EA5IOT/Medidor-de-ruido-solar/README.md

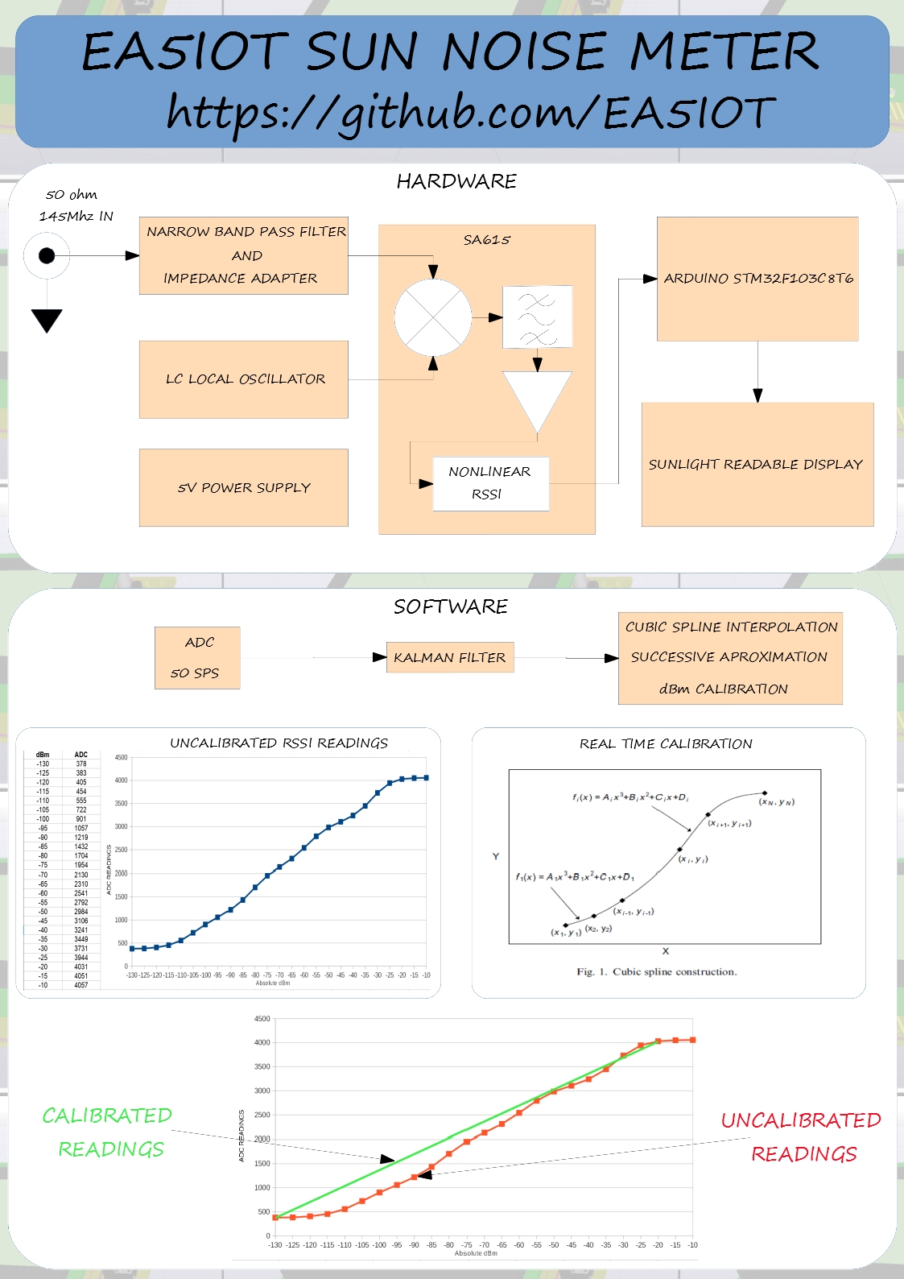
[picture p1: assets/import.png]
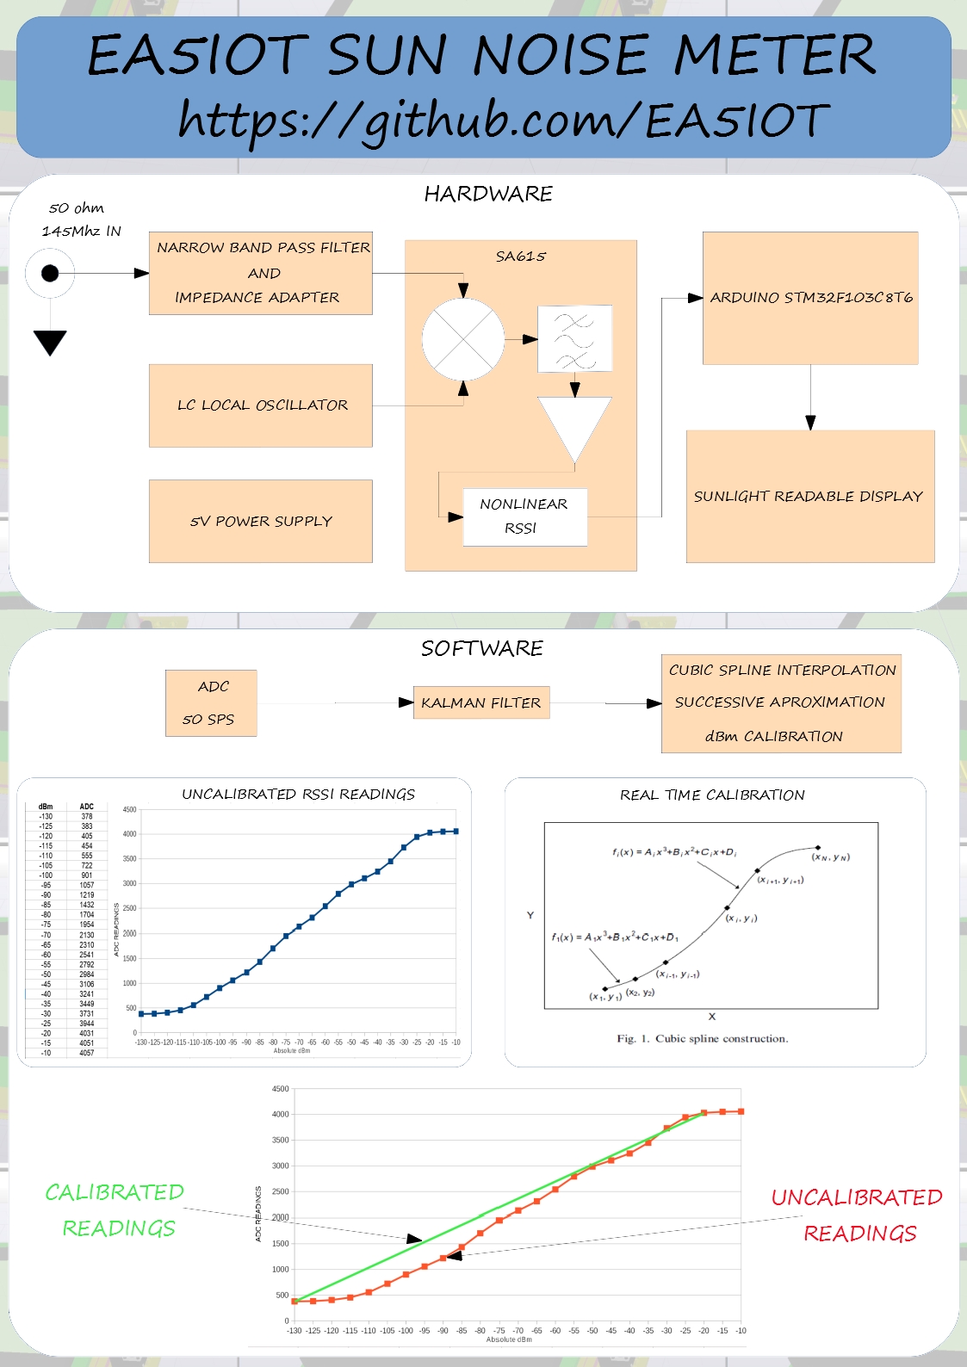
[picture p2: assets/Presentacion1.jpg]
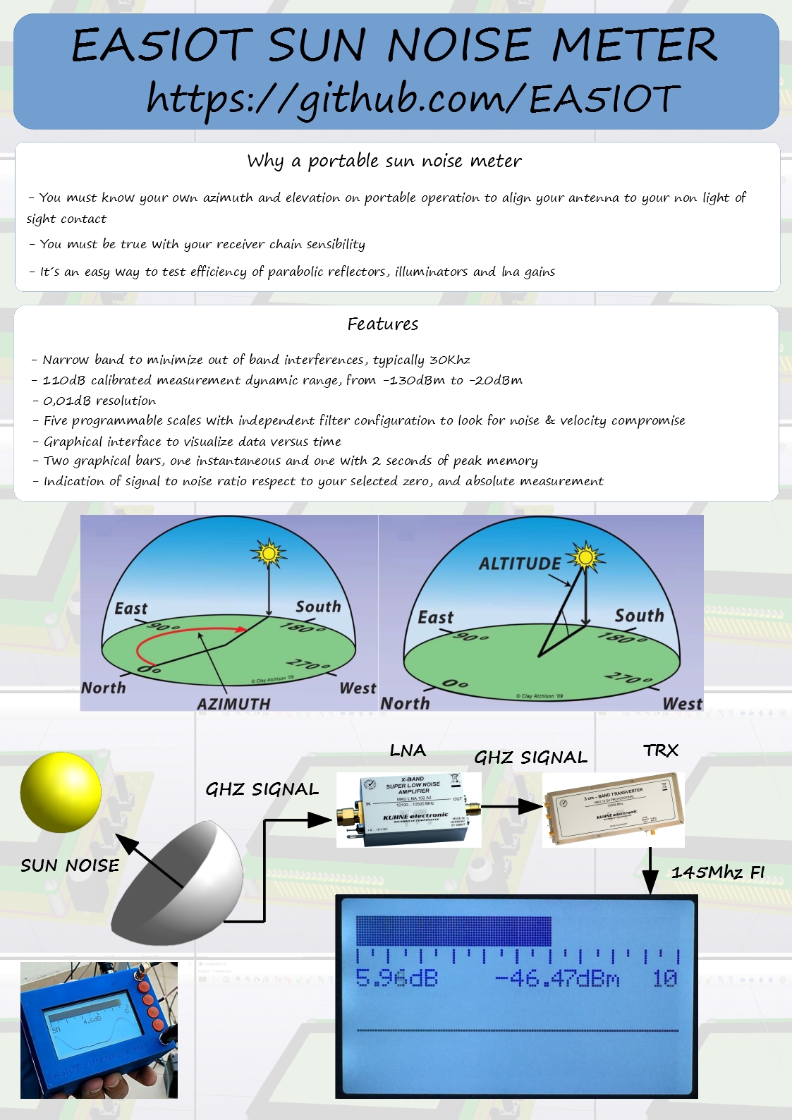
[picture p3: assets/Presentacion2.jpg]
