EA5IOT/Medidor-de-ruido-solar/Medidor_ruido_solar/Presentacion/EATIOT SUN NOISE METER.pdf

## HARDWARE

# EA5IOT SUN NOISE METER

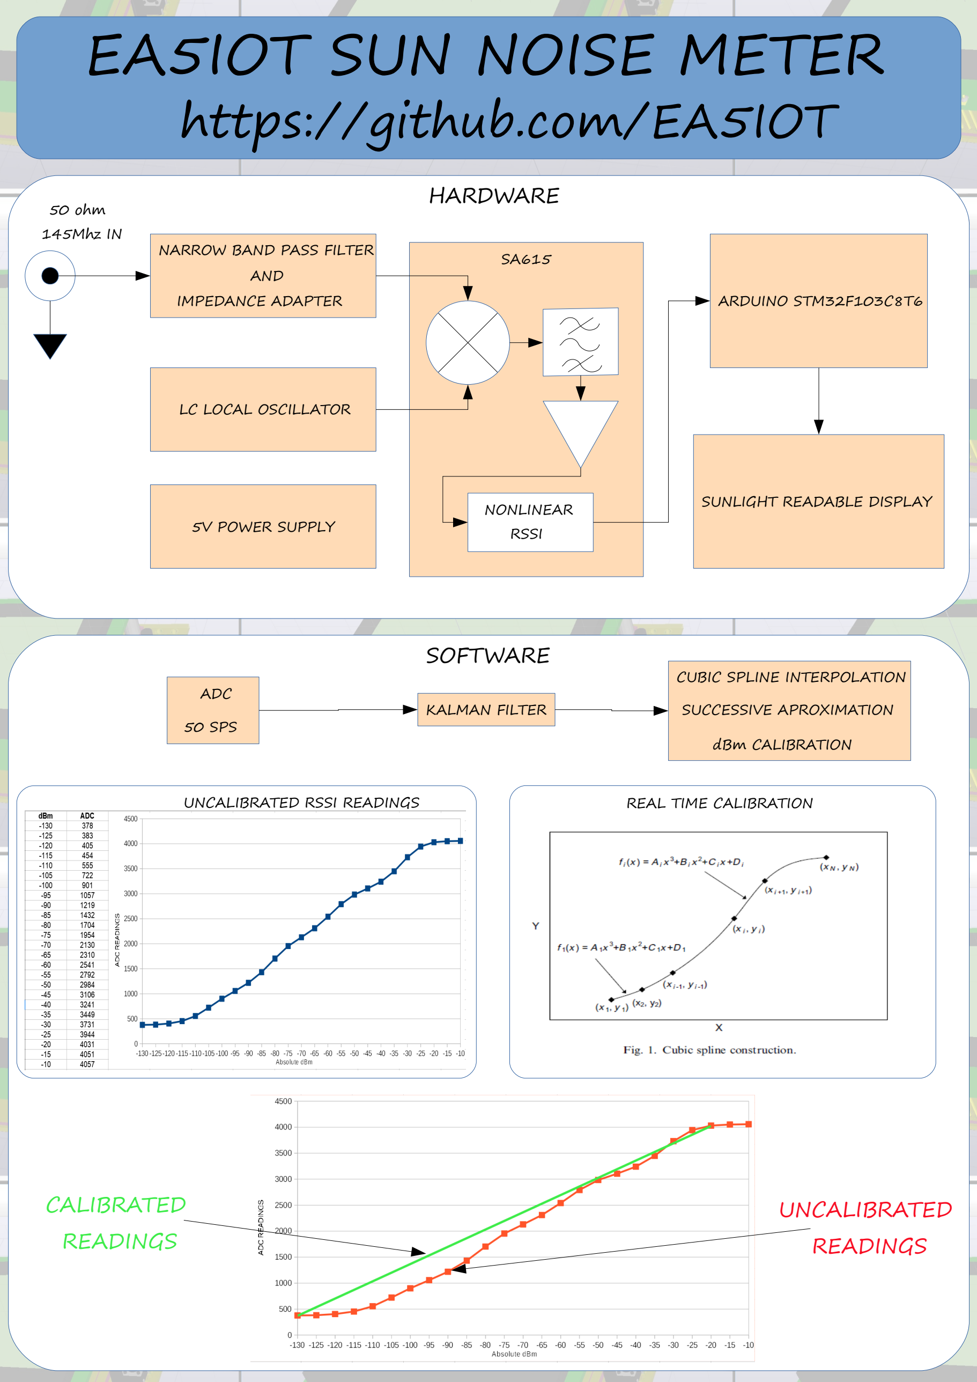
[picture p4: page 1]

NARROW BAND PASS FILTER
AND
IMPEDANCE ADAPTER

5V POWER SUPPLY

SA615

LC LOCAL OSCILLATOR

RSSI

ARDUINO STM32F103C8T6

SUNLIGHT READABLE DISPLAY

## SOFTWARE

ADC
50 SPS

KALMAN FILTER

CUBIC SPLINE INTERPOLATION SUCCESSIVE APROXIMATION

50 ohm
145Mhz IN

dBm CALIBRATION

NONLINEAR

UNCALIBRATED RSSI READINGS | REAL TIME CALIBRATION

## UNCALIBRATED READINGS

## CALIBRATED READINGS

# https://github.com/EA5IOT

# EA5IOT SUN NOISE METER

# https://github.com/EA5IOT

## Why a portable sun noise meter

- You must know your own azimuth and elevation on portable operation to align your antenna to your non light of sight contact
- You must be true with your receiver chain sensibility
- It´s an easy way to test efficiency of parabolic reflectors, illuminators and lna gains

## Features

- Narrow band to minimize out of band interferences, typically 30Khz
- 110dB calibrated measurement dynamic range, from -130dBm to -20dBm
- 0,01dB resolution
- Five programmable scales with independent filter configuration to look for noise & velocity compromise
- Graphical interface to visualize data versus time
- Two graphical bars, one instantaneous and one with 2 seconds of peak memory
- Indication of signal to noise ratio respect to your selected zero, and absolute measurement

## SUN NOISE

## GHZ SIGNAL

GHZ SIGNAL LNA | TRX

## 145Mhz FI
