EA5IOT/Medidor-de-ruido-solar/Medidor_ruido_solar/Fotos/428928830_282178.jpg

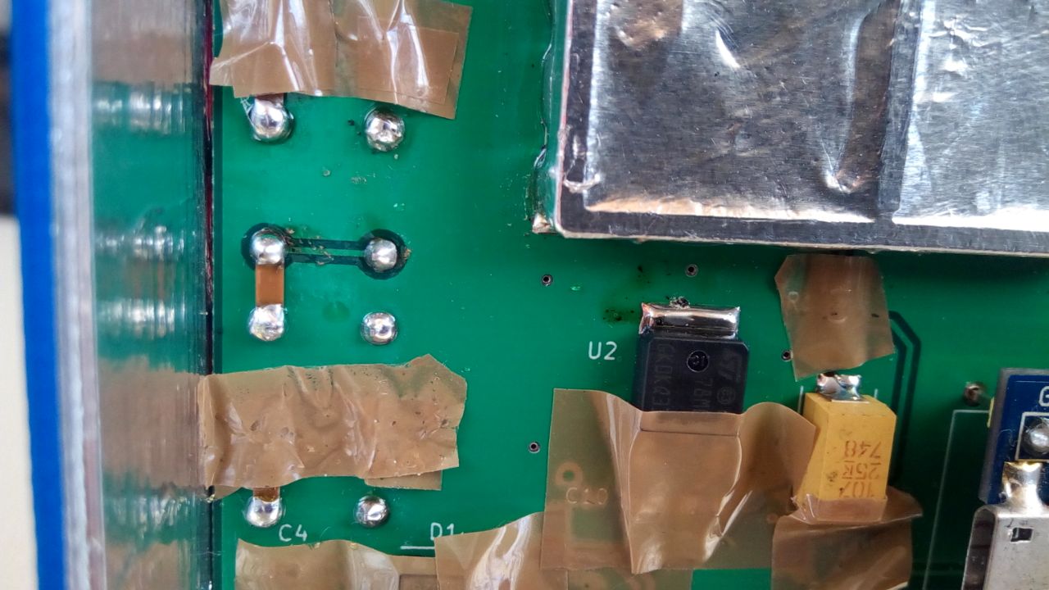
Medidor_ruido_solar/Fotos/428928830_282178.jpg
