EA5IOT/Medidor-de-ruido-solar/Medidor_ruido_solar/Fotos/428933439_148707.jpg

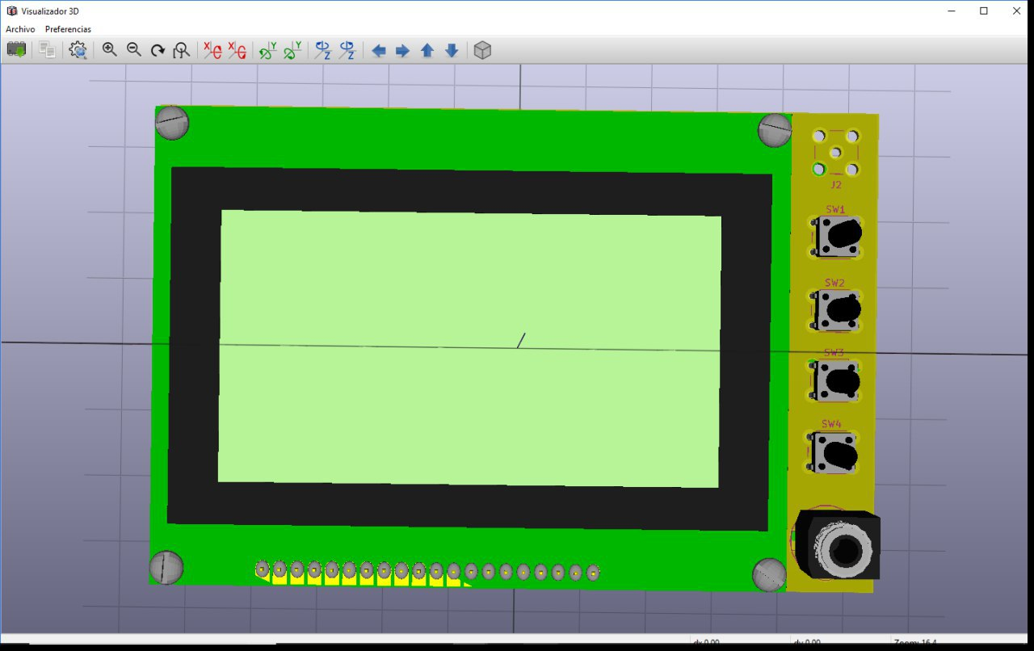
Medidor_ruido_solar/Fotos/428933439_148707.jpg
