EA5IOT/Medidor-de-ruido-solar/Medidor_ruido_solar/Fotos/428935115_189661.jpg

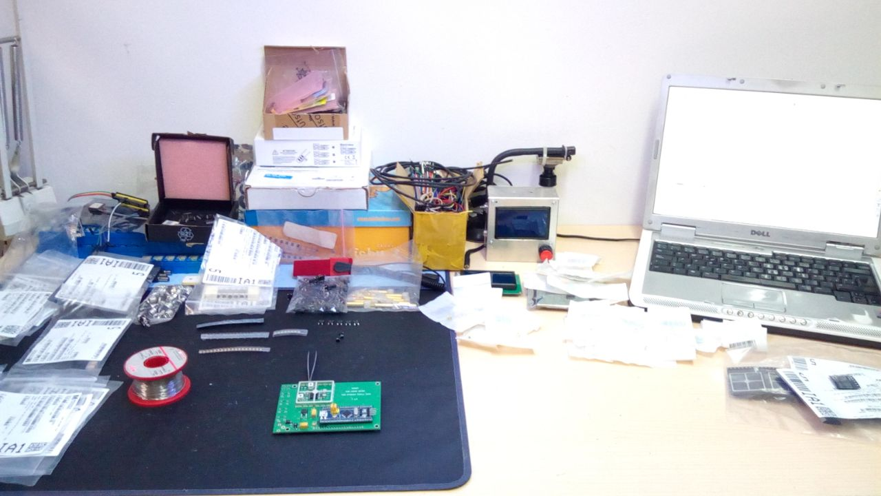
Medidor_ruido_solar/Fotos/428935115_189661.jpg
