EA5IOT/Medidor-de-ruido-solar/Medidor_ruido_solar/Fotos/428937697_245249.jpg

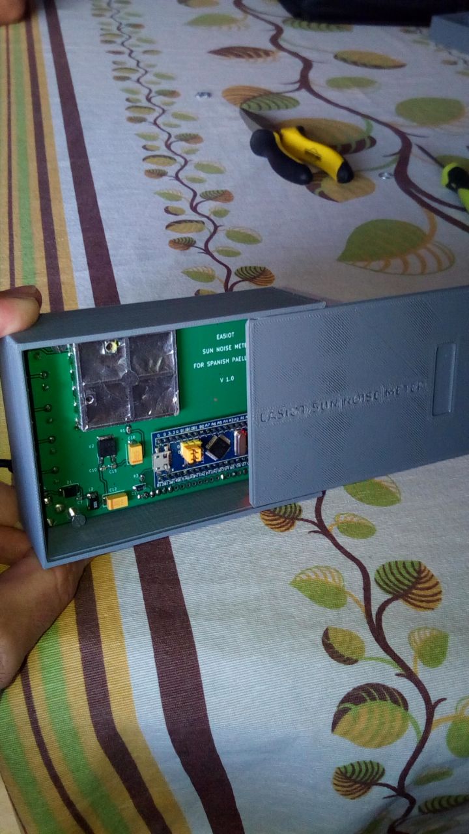
Medidor_ruido_solar/Fotos/428937697_245249.jpg
