EA5IOT/Medidor-de-ruido-solar/Medidor_ruido_solar/Fotos/435502254_330888.jpg

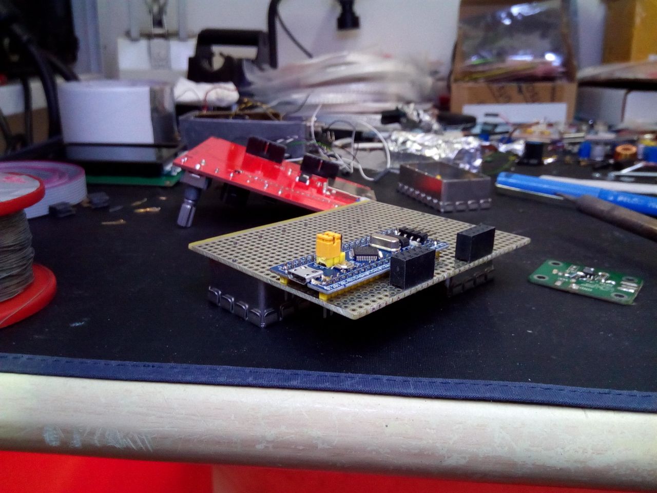
Medidor_ruido_solar/Fotos/435502254_330888.jpg
