EA5IOT/Medidor-de-ruido-solar/Medidor_ruido_solar/Fotos/435504594_331603.jpg

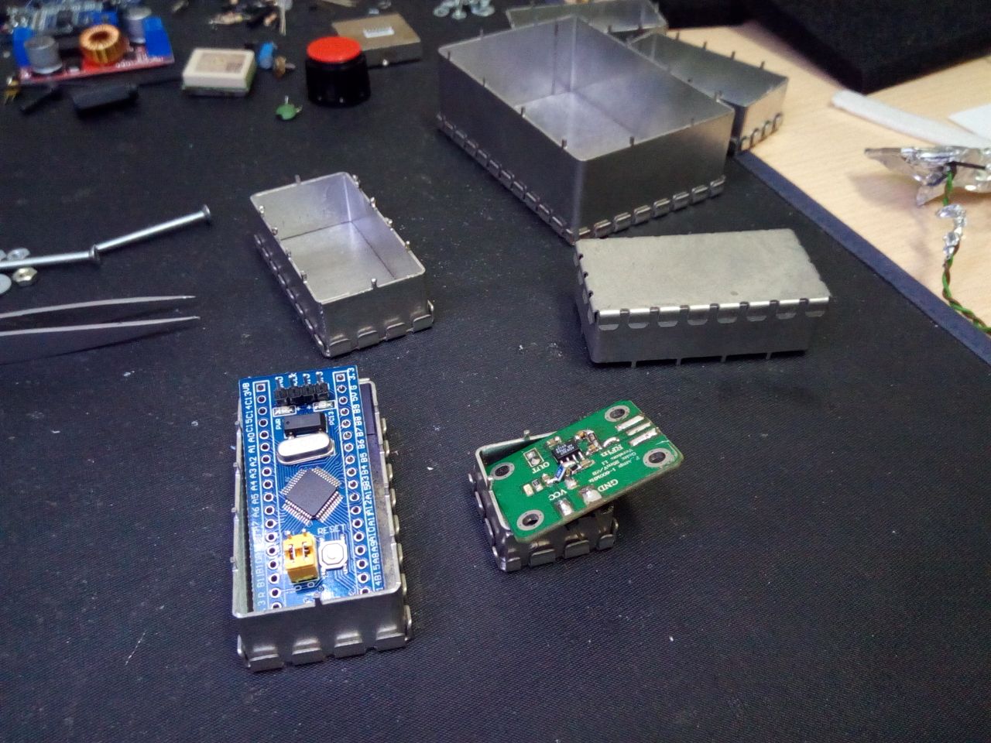
Medidor_ruido_solar/Fotos/435504594_331603.jpg
