EA5IOT/Medidor-de-ruido-solar/Medidor_ruido_solar/Fotos/438711929_137093.jpg

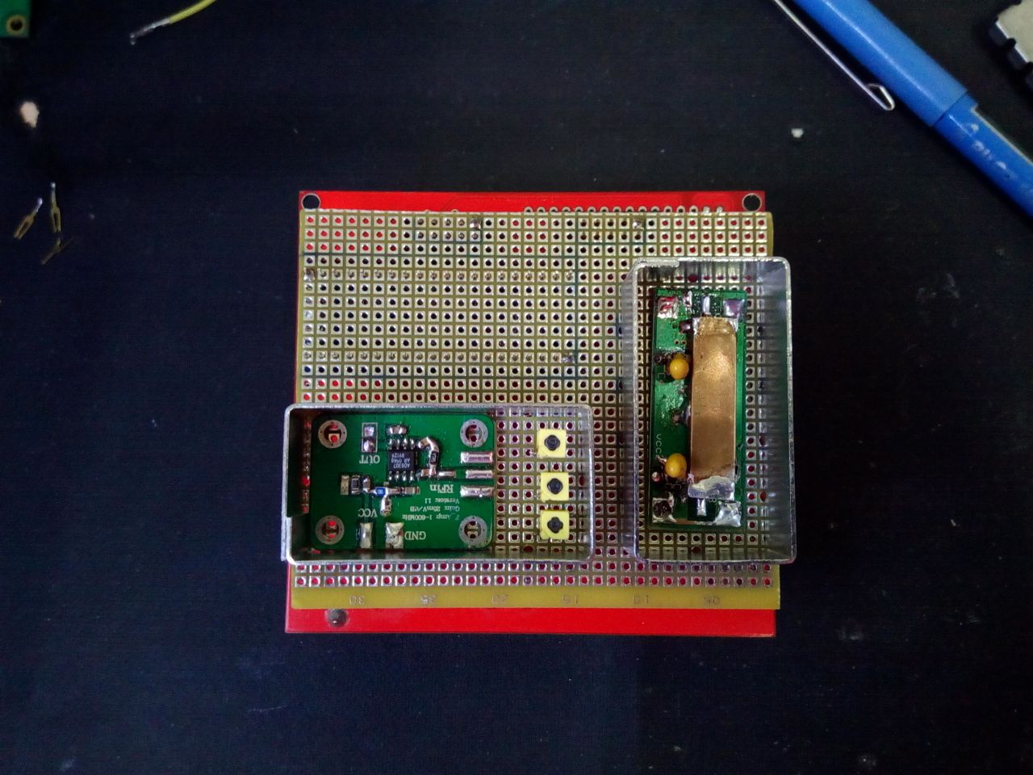
Medidor_ruido_solar/Fotos/438711929_137093.jpg
