EA5IOT/Medidor-de-ruido-solar/Medidor_ruido_solar/Fotos/438714214_136018.jpg

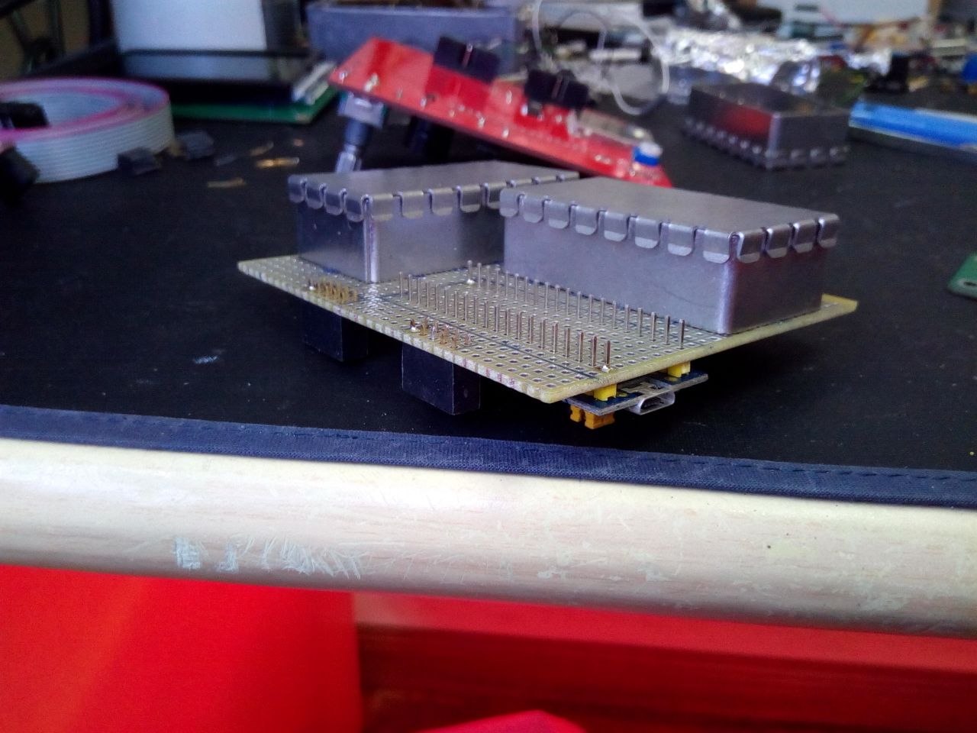
Medidor_ruido_solar/Fotos/438714214_136018.jpg
