EA5IOT/Medidor-de-ruido-solar/Medidor_ruido_solar/Fotos/438714601_136113.jpg

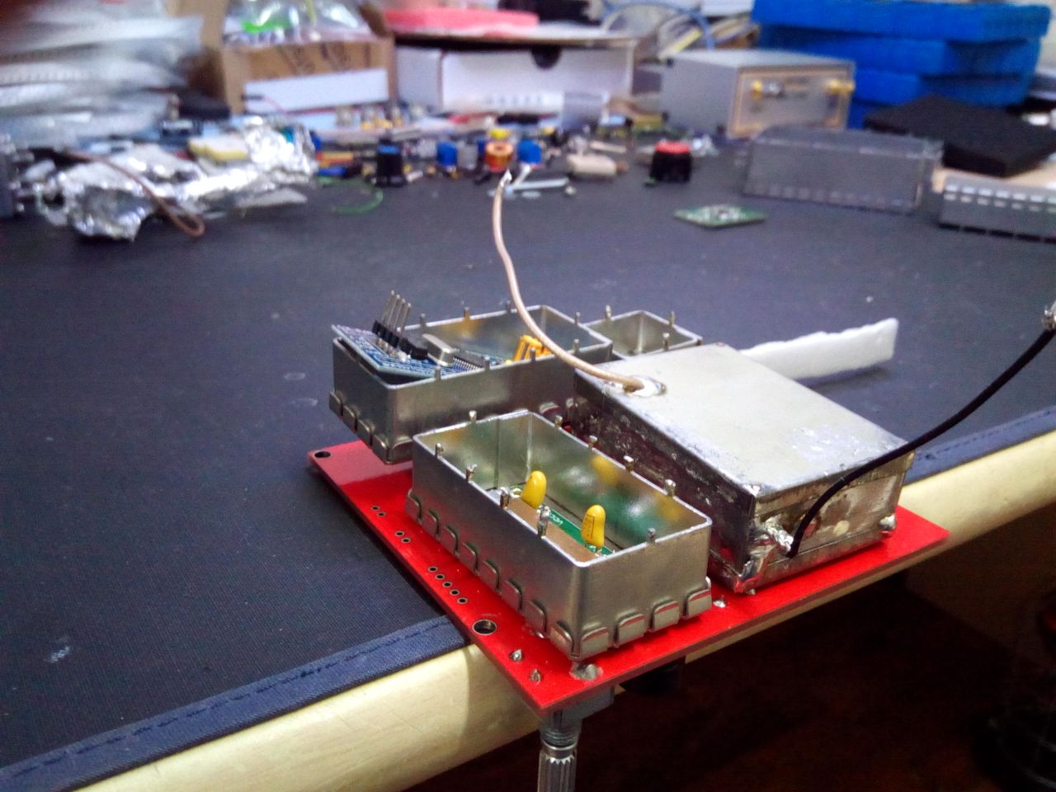
Medidor_ruido_solar/Fotos/438714601_136113.jpg
