EA5IOT/Medidor-de-ruido-solar/Medidor_ruido_solar/Fotos/438718184_130150.jpg

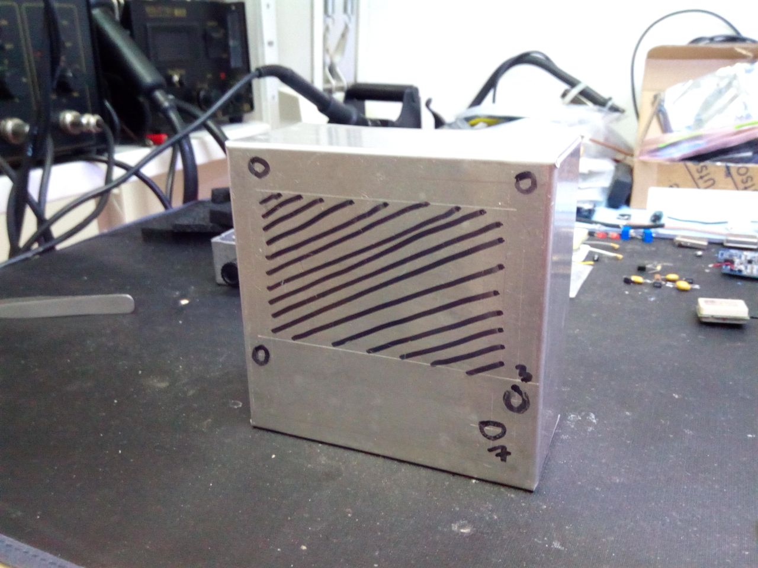
Medidor_ruido_solar/Fotos/438718184_130150.jpg
