EA5IOT/Medidor-de-ruido-solar/Medidor_ruido_solar/Fotos/439017442_168627.jpg

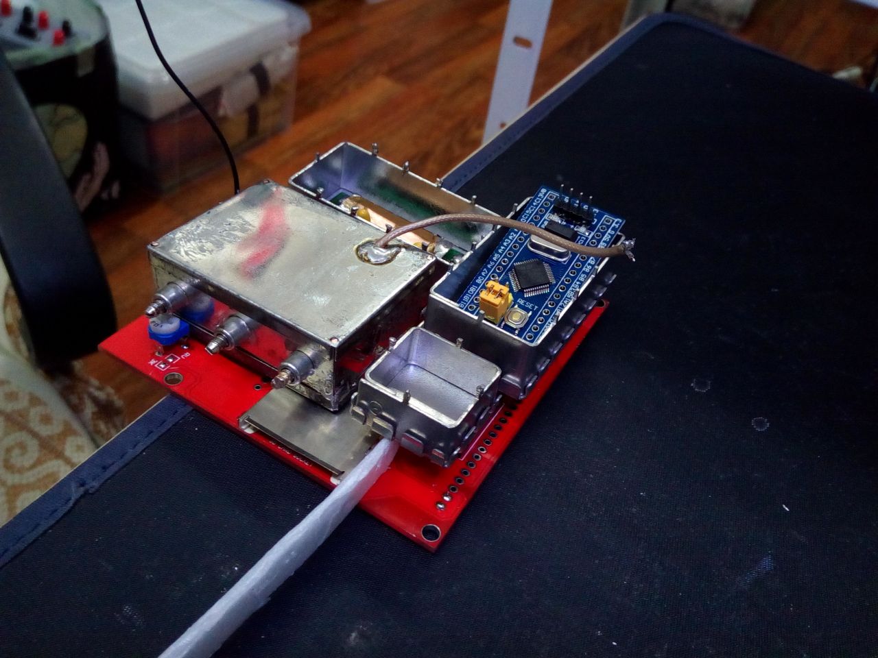
Medidor_ruido_solar/Fotos/439017442_168627.jpg
