EA5IOT/Medidor-de-ruido-solar/Medidor_ruido_solar/Fotos/439632301_316374.jpg

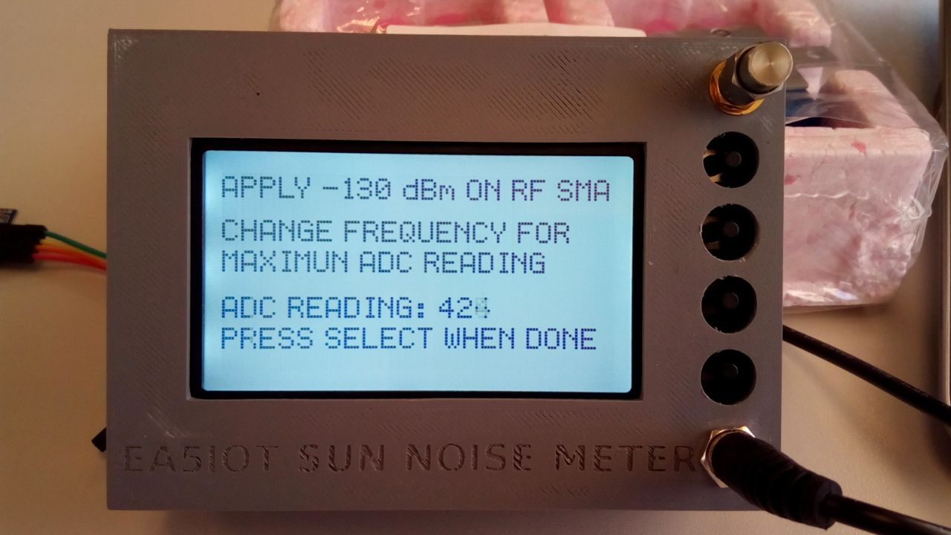
Medidor_ruido_solar/Fotos/439632301_316374.jpg
