EA5IOT/Medidor-de-ruido-solar/Medidor_ruido_solar/Fotos/439636108_252539.jpg

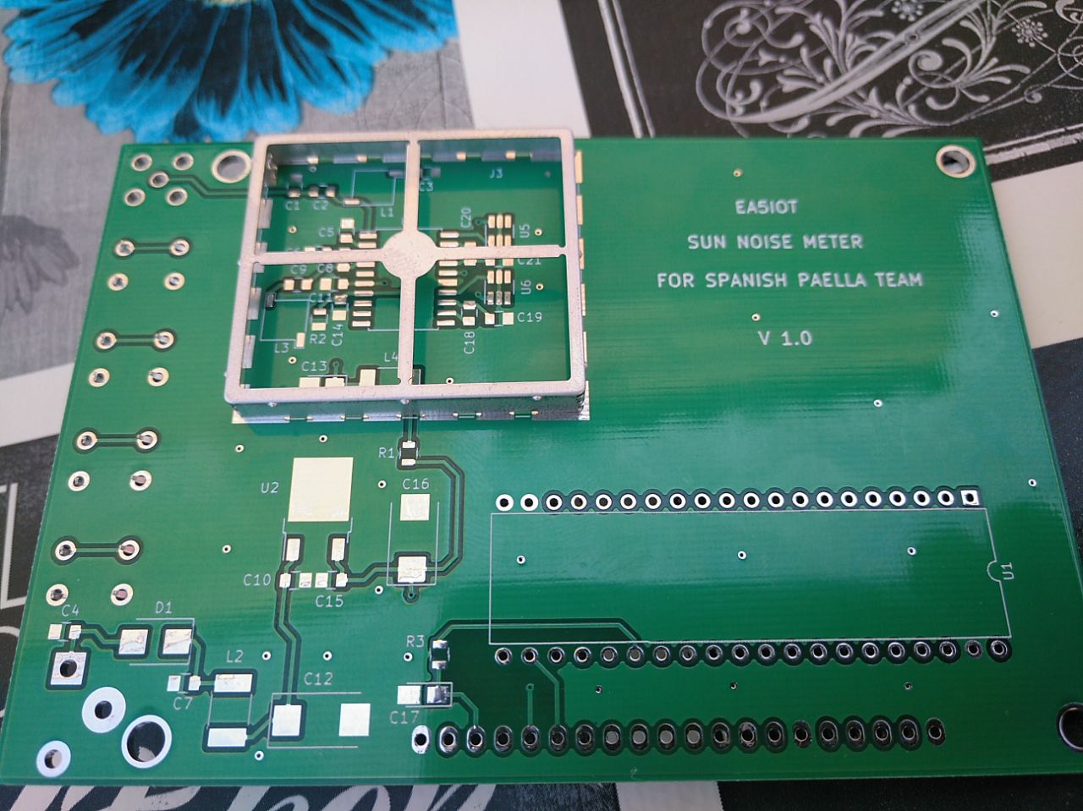
Medidor_ruido_solar/Fotos/439636108_252539.jpg
