EA5IOT/Medidor-de-ruido-solar/Medidor_ruido_solar/Fotos/439636724_227444.jpg

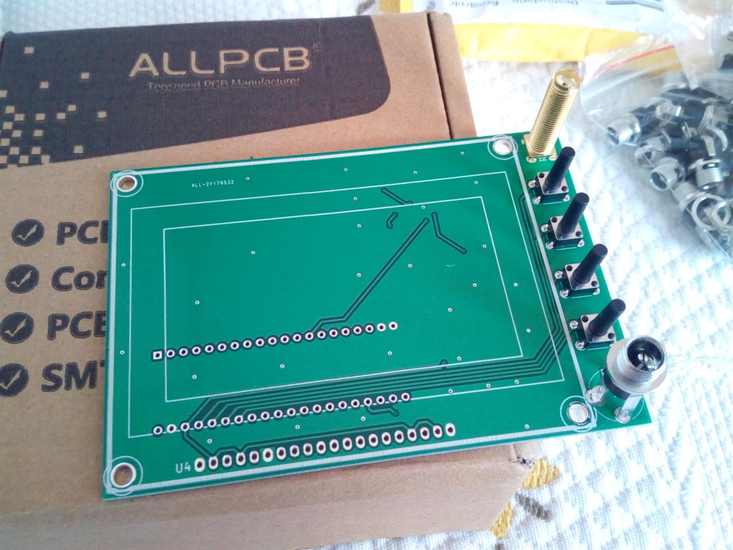
Medidor_ruido_solar/Fotos/439636724_227444.jpg
