EA5IOT/Medidor-de-ruido-solar/Medidor_ruido_solar/Fotos/439639487_311773.jpg

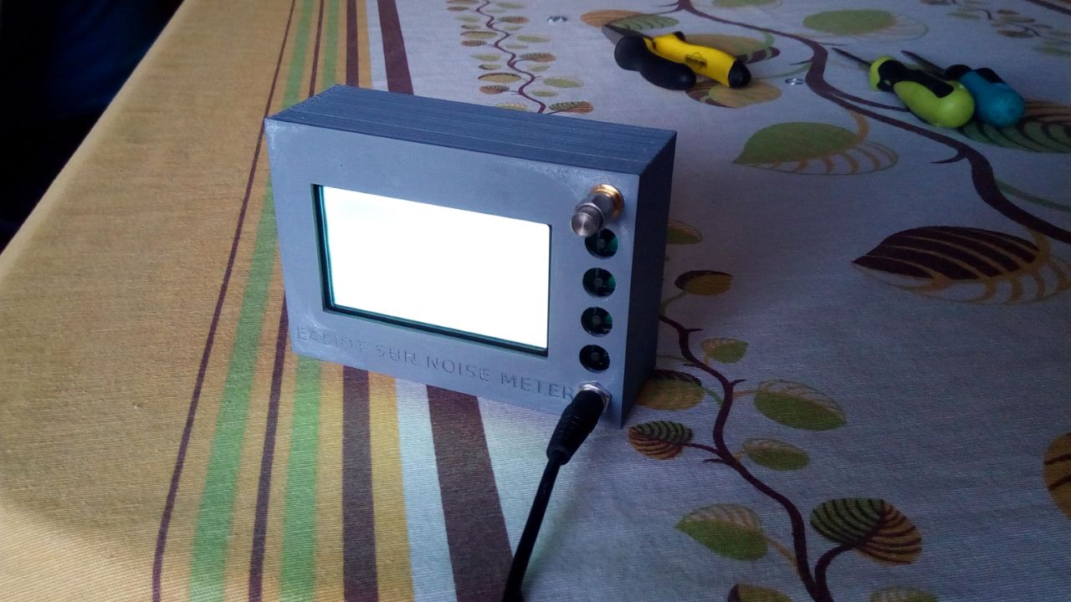
Medidor_ruido_solar/Fotos/439639487_311773.jpg
