EA5IOT/Medidor-de-ruido-solar/Medidor_ruido_solar/Fotos/445202381_45970.jpg

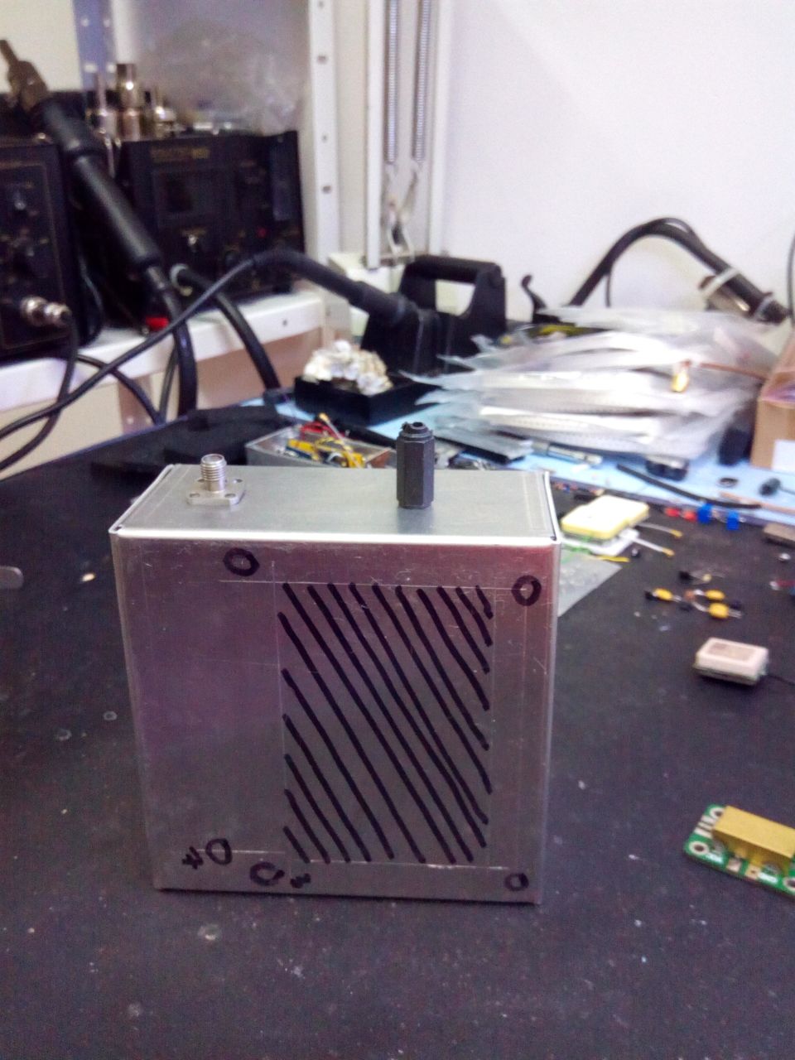
Medidor_ruido_solar/Fotos/445202381_45970.jpg
