EA5IOT/Medidor-de-ruido-solar/Medidor_ruido_solar/Fotos/445202713_50427.jpg

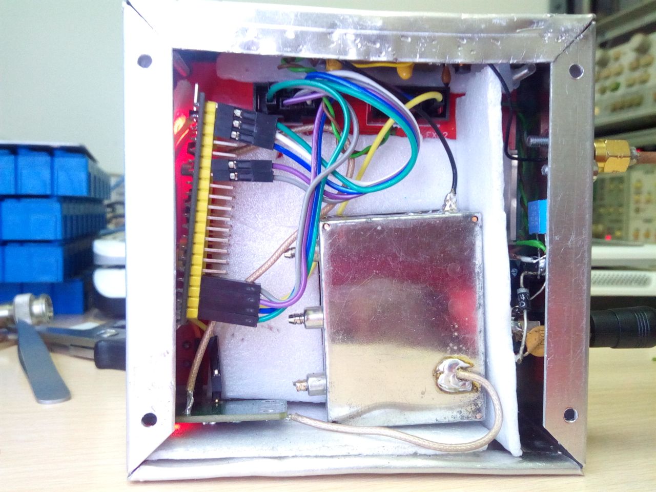
Medidor_ruido_solar/Fotos/445202713_50427.jpg
