EA5IOT/Medidor-de-ruido-solar/Medidor_ruido_solar/Fotos/445206151_46398.jpg

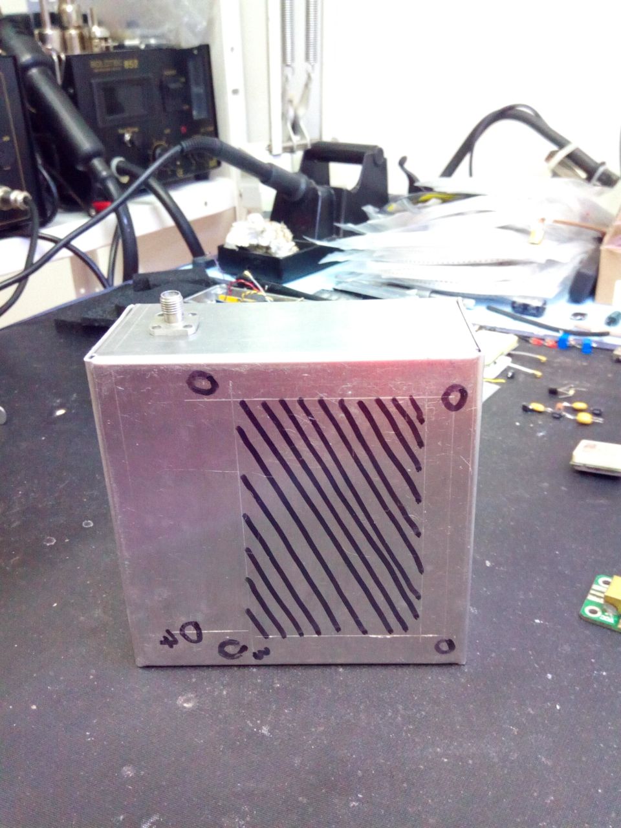
Medidor_ruido_solar/Fotos/445206151_46398.jpg
