EA5IOT/Medidor-de-ruido-solar/Medidor_ruido_solar/Fotos/445206616_52301.jpg

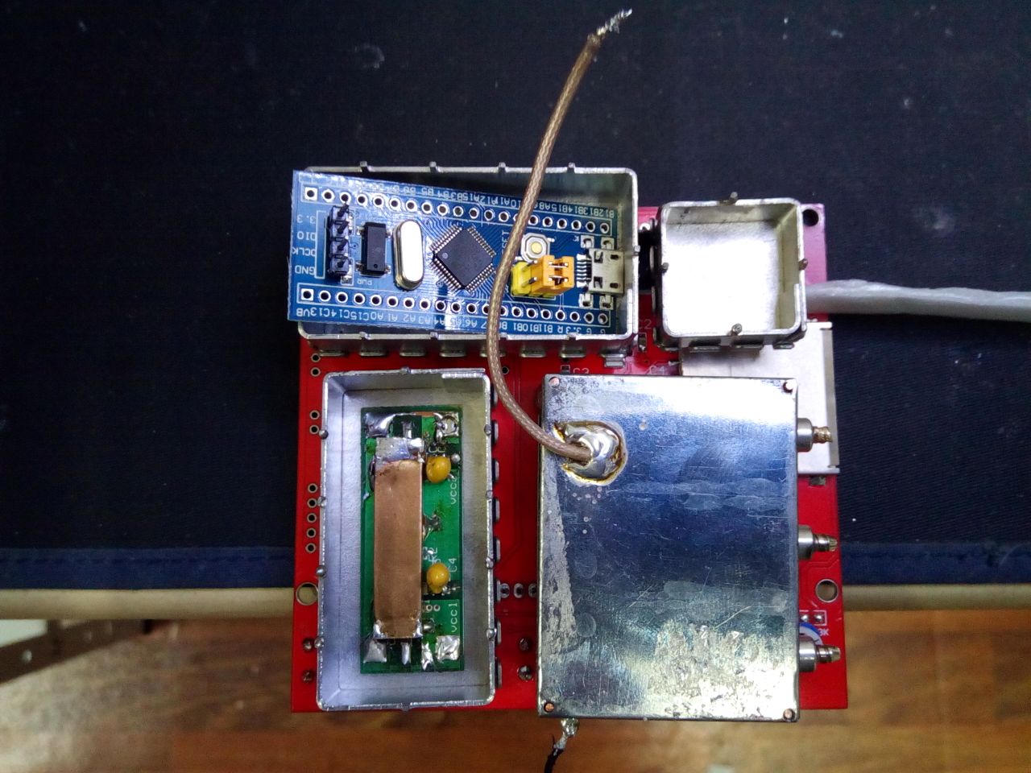
Medidor_ruido_solar/Fotos/445206616_52301.jpg
