EA5IOT/Medidor-de-ruido-solar/Medidor_ruido_solar/Fotos/445206702_371699.jpg

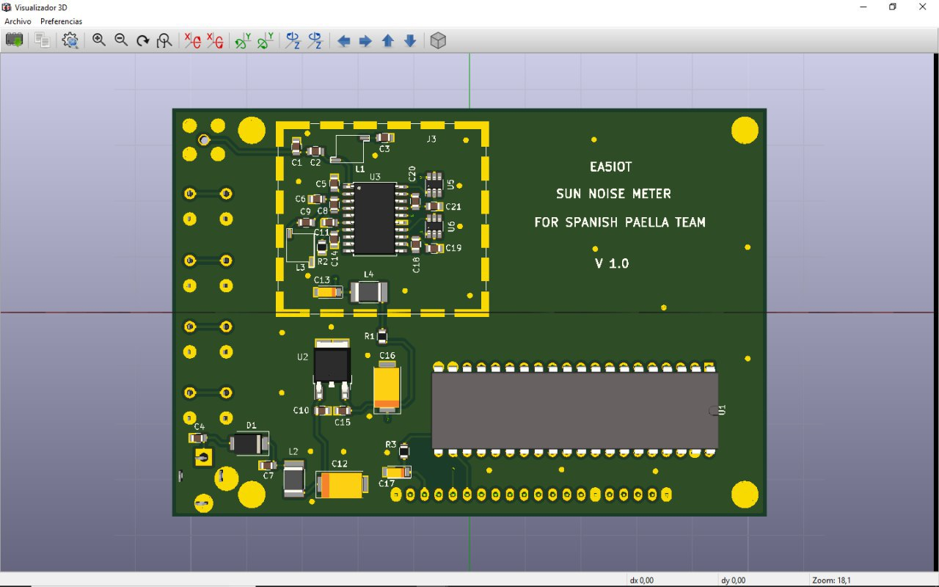
Medidor_ruido_solar/Fotos/445206702_371699.jpg
