EA5IOT/Medidor-de-ruido-solar/Medidor_ruido_solar/Fotos/445209846_45803.jpg

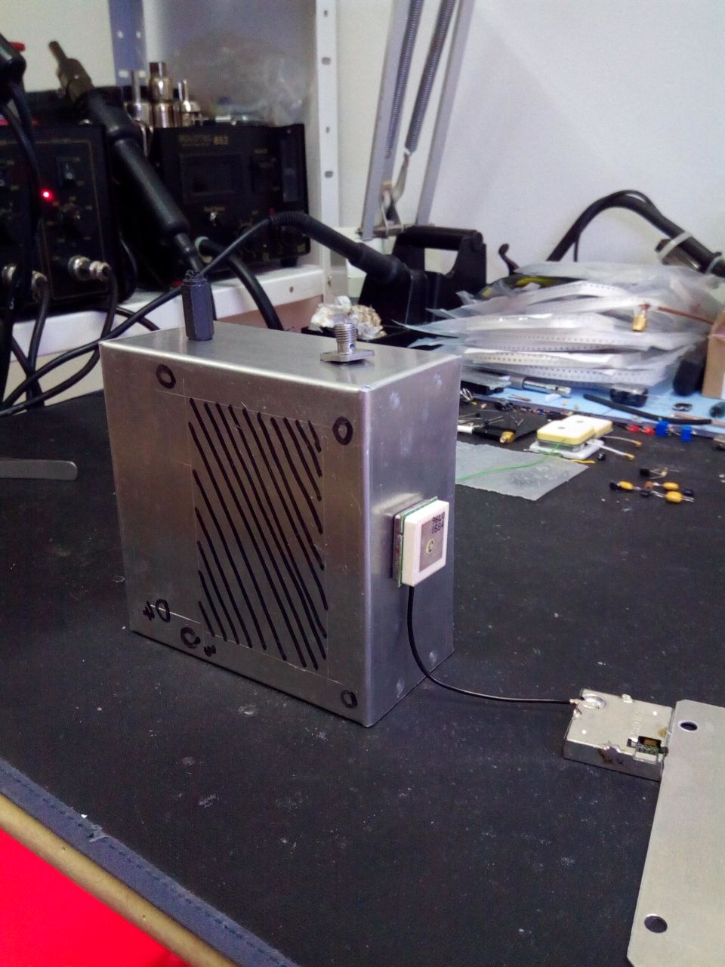
Medidor_ruido_solar/Fotos/445209846_45803.jpg
