EA5IOT/Medidor-de-ruido-solar/Medidor_ruido_solar/Fotos/445215017_45631.jpg

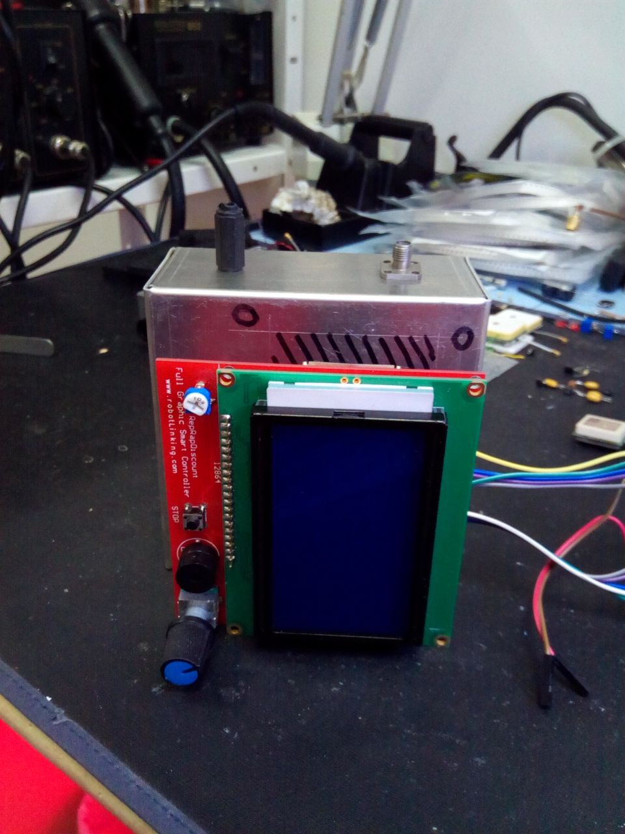
Medidor_ruido_solar/Fotos/445215017_45631.jpg
