EA5IOT/Medidor-de-ruido-solar/Medidor_ruido_solar/Fotos/445215138_364300.jpg

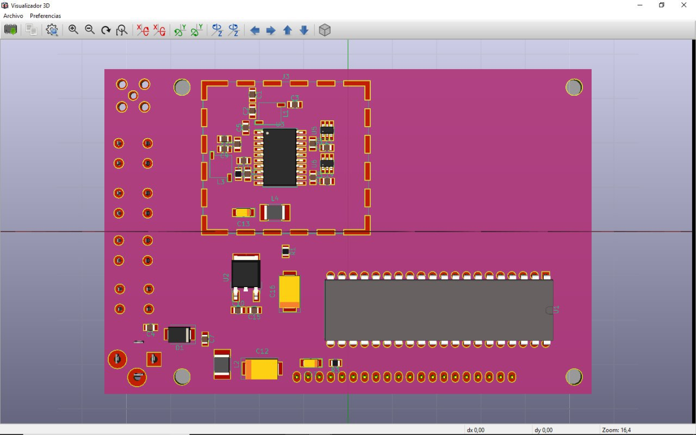
Medidor_ruido_solar/Fotos/445215138_364300.jpg
