EA5IOT/Medidor-de-ruido-solar/Medidor_ruido_solar/Fotos/445215960_52065.jpg

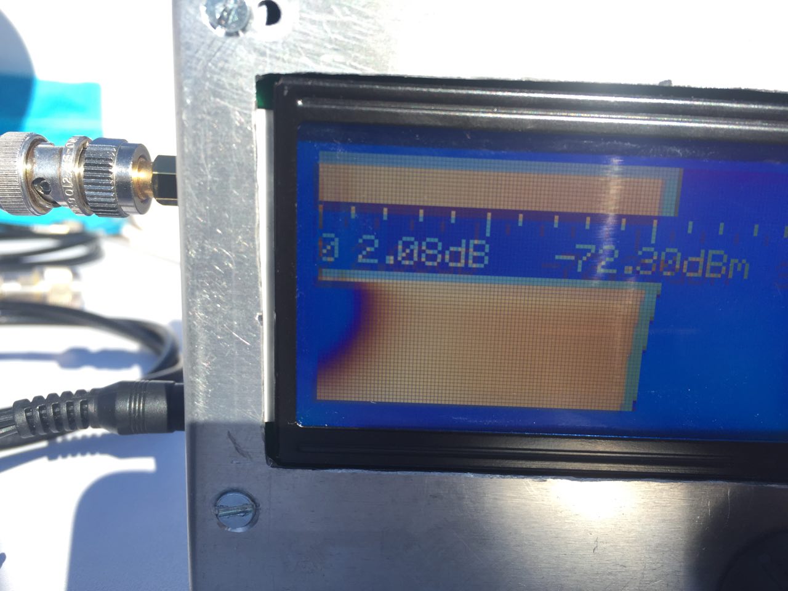
Medidor_ruido_solar/Fotos/445215960_52065.jpg
