EA5IOT/Medidor-de-ruido-solar/Medidor_ruido_solar/Fotos/445301020_53054.jpg

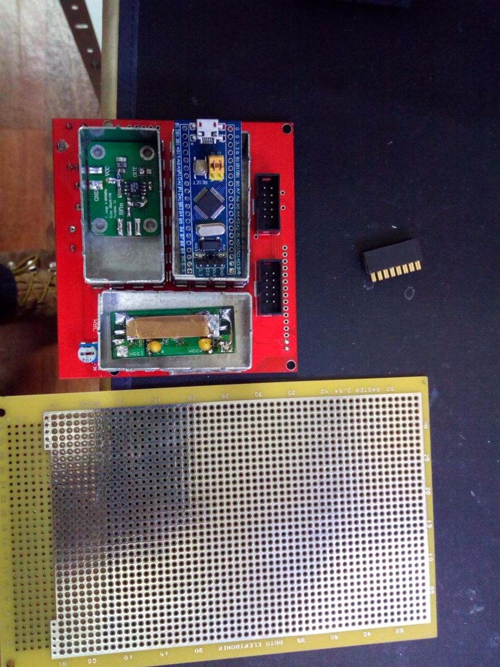
Medidor_ruido_solar/Fotos/445301020_53054.jpg
