EA5IOT/Medidor-de-ruido-solar/Medidor_ruido_solar/Fotos/445306580_37858.jpg

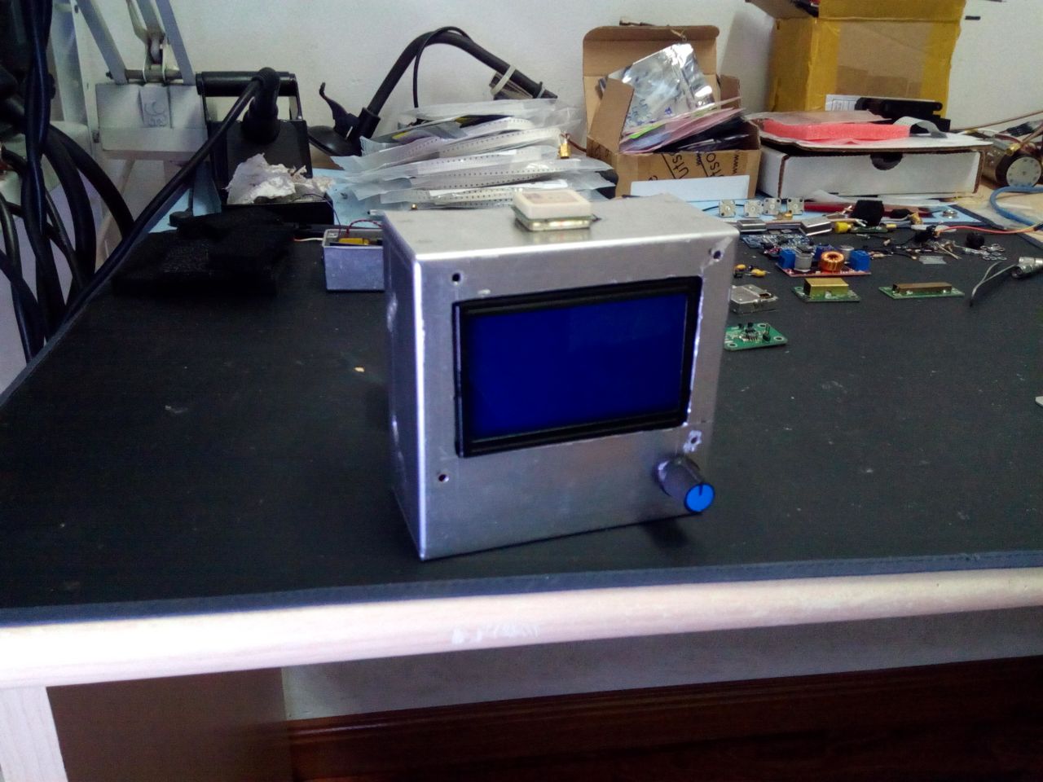
Medidor_ruido_solar/Fotos/445306580_37858.jpg
