EA5IOT/Medidor-de-ruido-solar/Medidor_ruido_solar/Fotos/445315142_364129.jpg

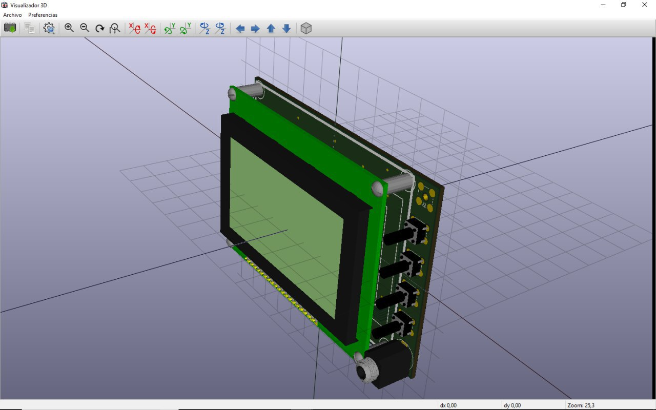
Medidor_ruido_solar/Fotos/445315142_364129.jpg
