EA5IOT/Medidor-de-ruido-solar/Medidor_ruido_solar/Fotos/445316441_36276.jpg

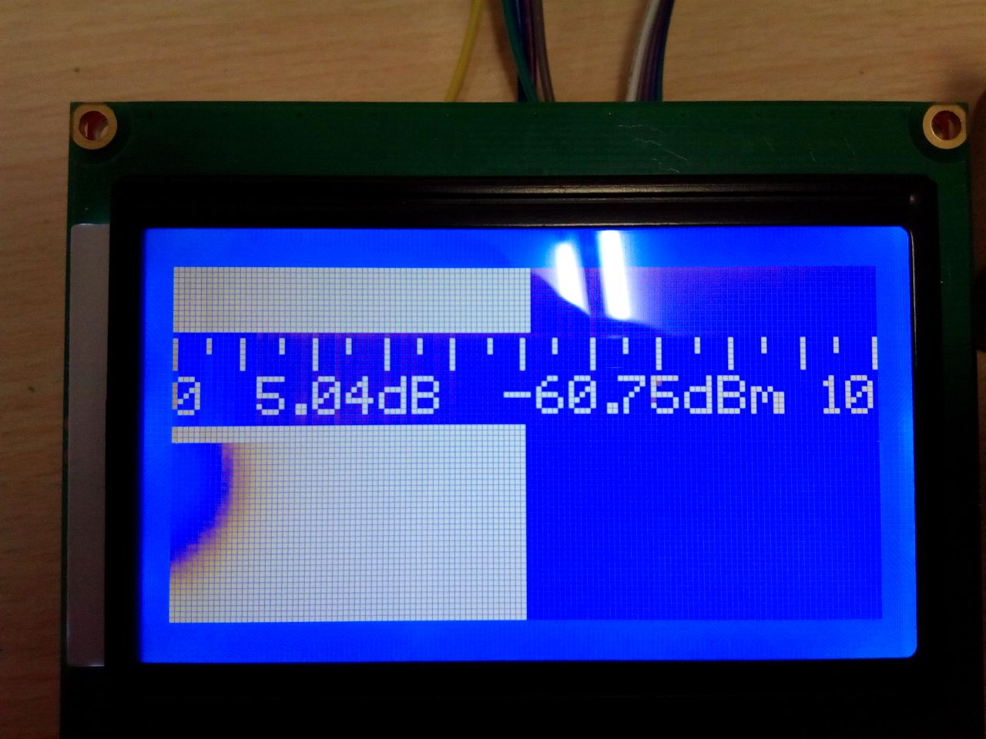
Medidor_ruido_solar/Fotos/445316441_36276.jpg
