EA5IOT/Medidor-de-ruido-solar/Medidor_ruido_solar/Fotos/445409938_356195.jpg

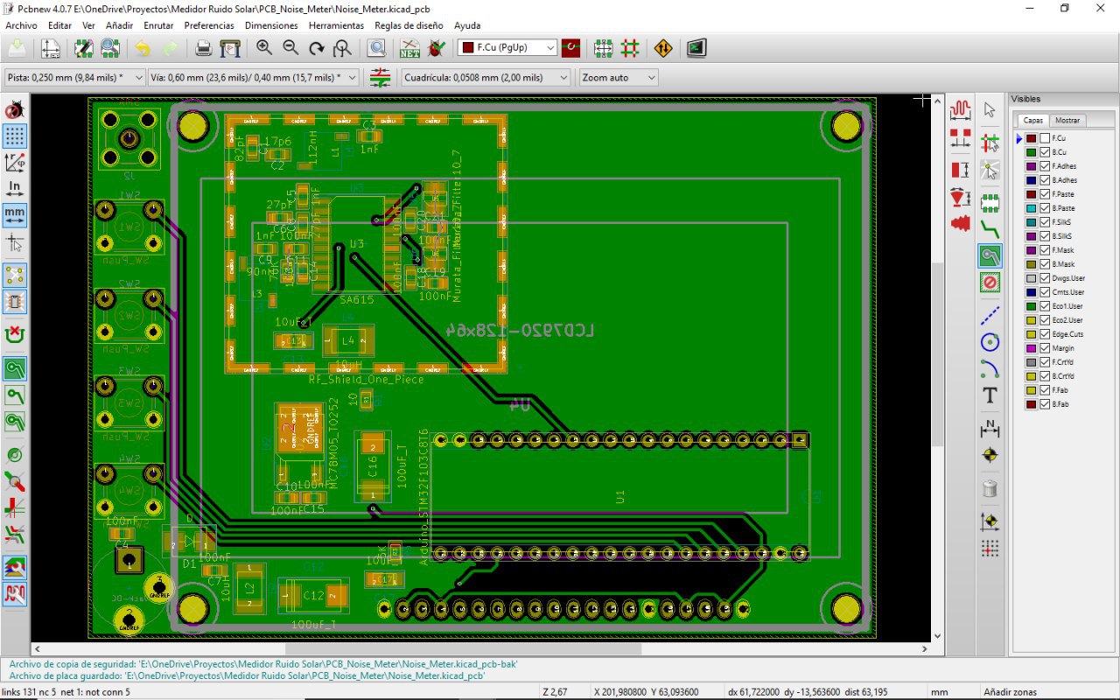
Medidor_ruido_solar/Fotos/445409938_356195.jpg
