EA5IOT/Medidor-de-ruido-solar/Medidor_ruido_solar/Fotos/445413603_357429.jpg

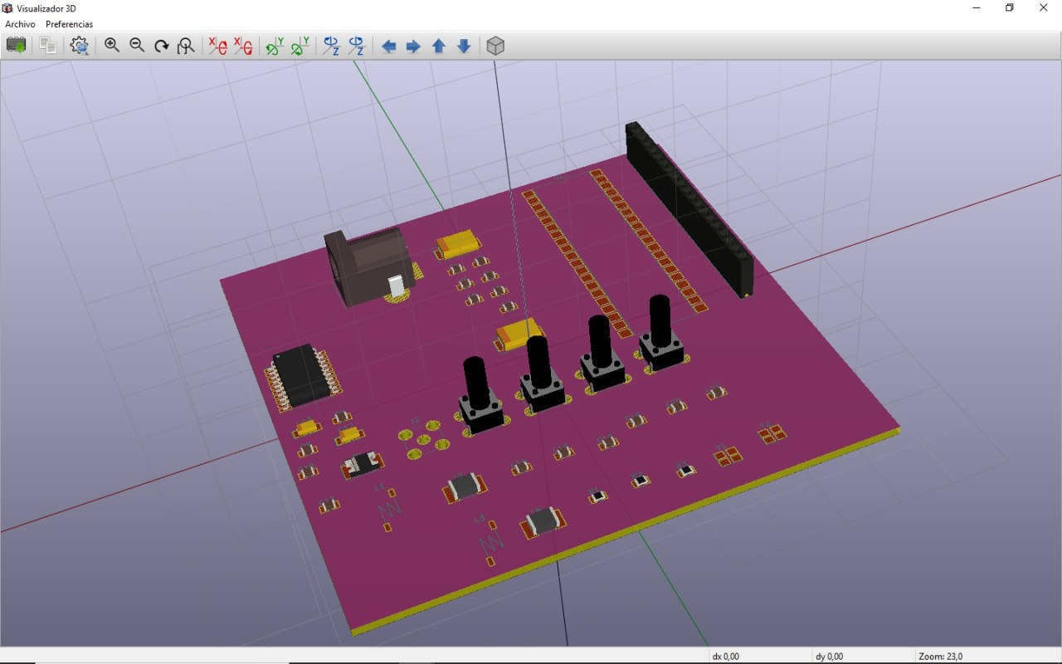
Medidor_ruido_solar/Fotos/445413603_357429.jpg
