EA5IOT/Medidor-de-ruido-solar/Medidor_ruido_solar/Fotos/445520478_43323.jpg

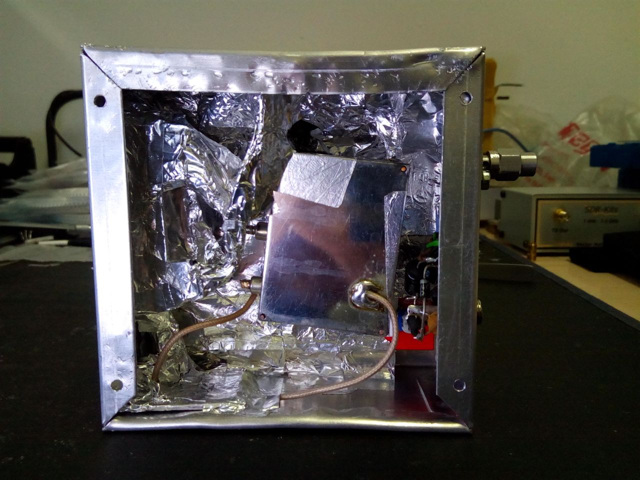
Medidor_ruido_solar/Fotos/445520478_43323.jpg
