EA5IOT/Medidor-de-ruido-solar/Medidor_ruido_solar/Fotos/445602304_44149.jpg

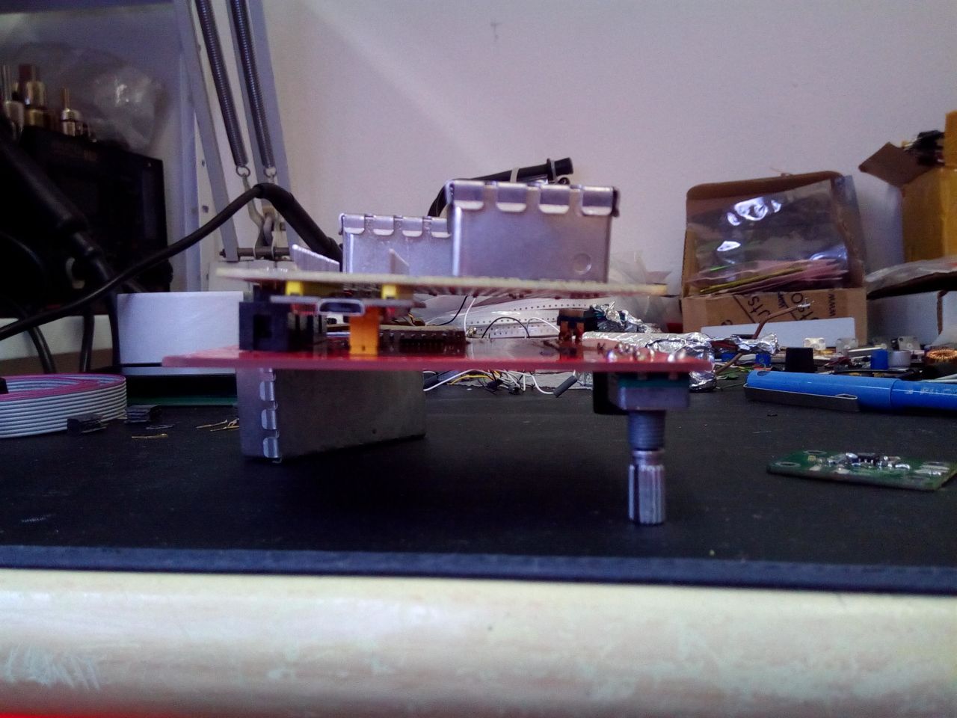
Medidor_ruido_solar/Fotos/445602304_44149.jpg
