EA5IOT/Medidor-de-ruido-solar/Medidor_ruido_solar/Fotos/445602365_42355.jpg

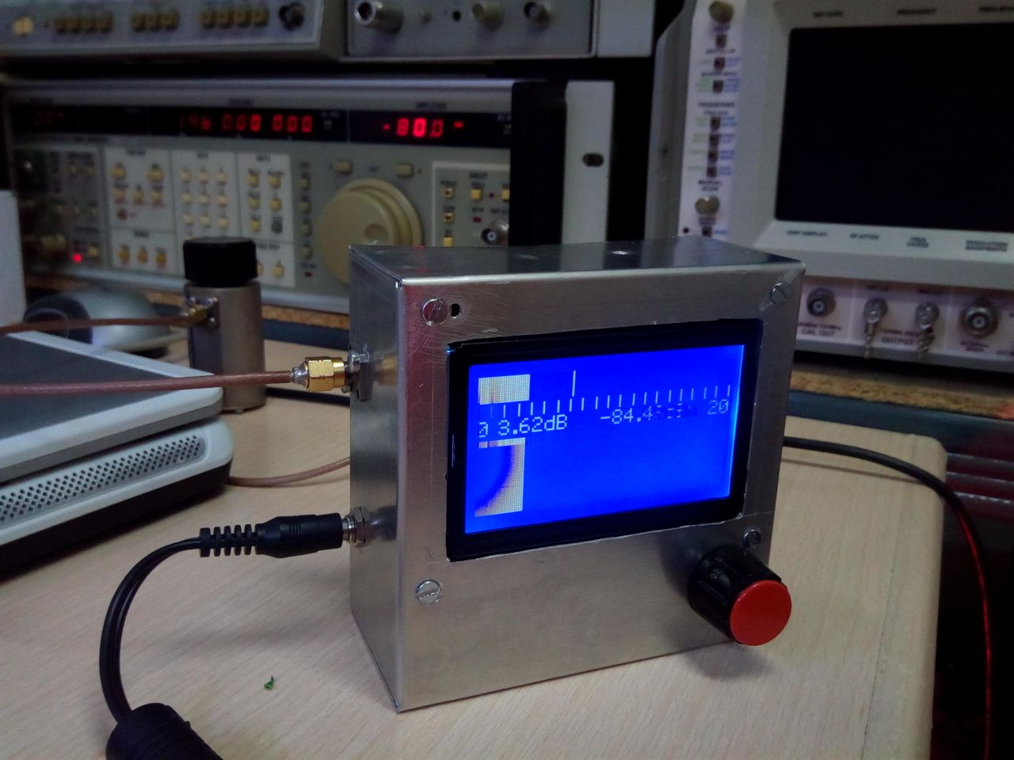
Medidor_ruido_solar/Fotos/445602365_42355.jpg
