EA5IOT/Medidor-de-ruido-solar/Medidor_ruido_solar/Fotos/445728507_158008.jpg

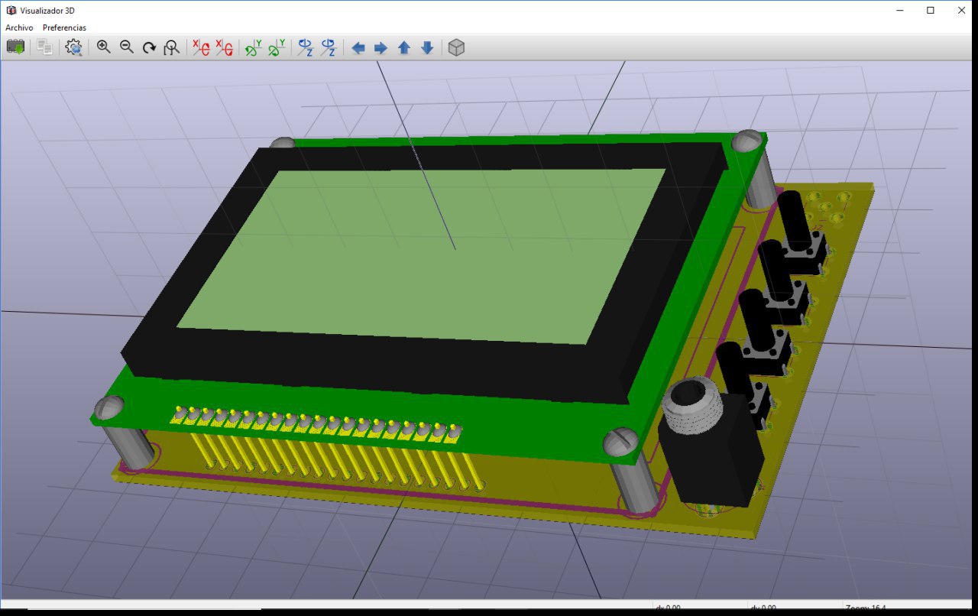
Medidor_ruido_solar/Fotos/445728507_158008.jpg
