EA5IOT/Medidor-de-ruido-solar/Medidor_ruido_solar/Fotos/445729581_295062.jpg

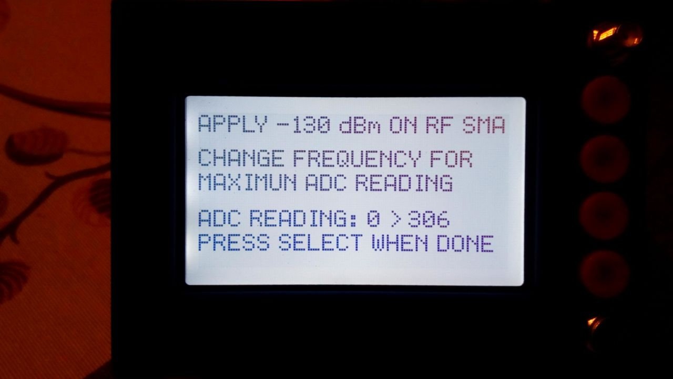
Medidor_ruido_solar/Fotos/445729581_295062.jpg
