EA5IOT/Medidor-de-ruido-solar/Medidor_ruido_solar/Fotos/445738944_215193.jpg

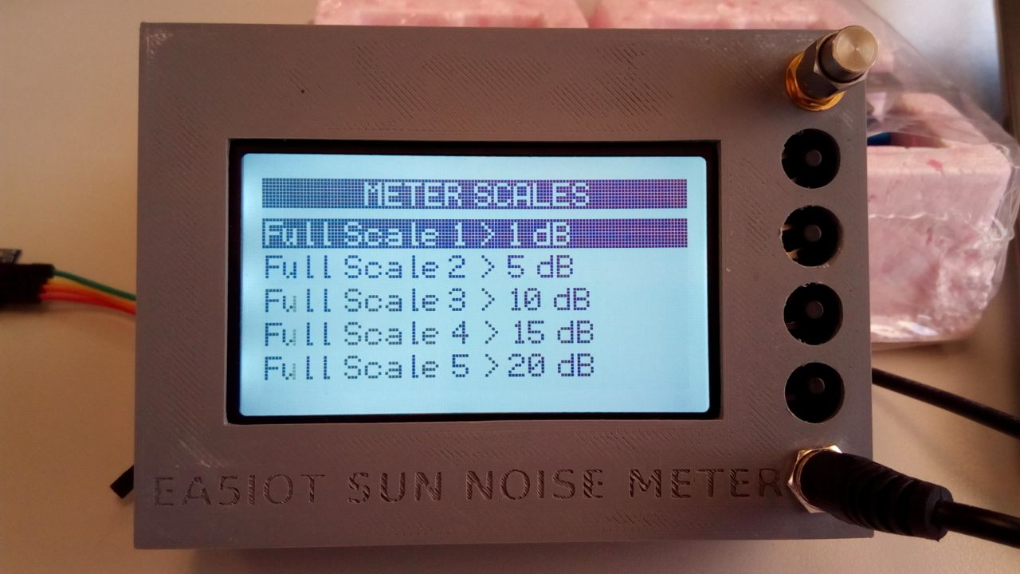
Medidor_ruido_solar/Fotos/445738944_215193.jpg
