EA5IOT/Medidor-de-ruido-solar/Medidor_ruido_solar/Fotos/445739392_211246.jpg

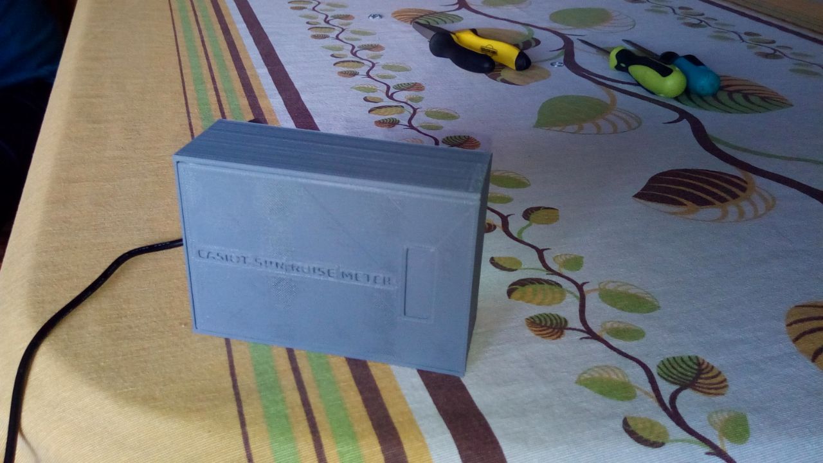
Medidor_ruido_solar/Fotos/445739392_211246.jpg
