EA5IOT/Medidor-de-ruido-solar/Medidor_ruido_solar/Fotos/446301250_116137.jpg

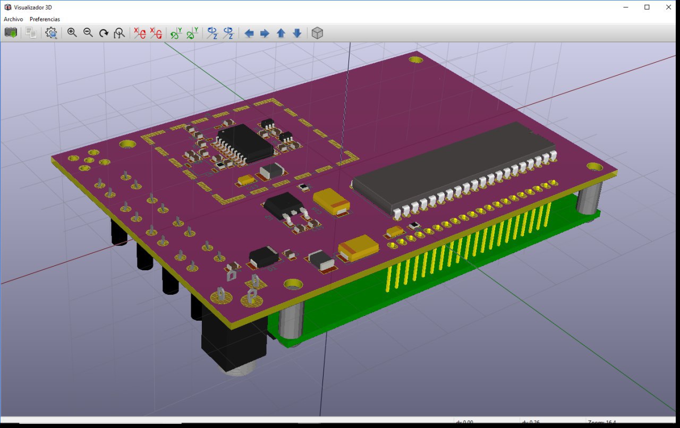
Medidor_ruido_solar/Fotos/446301250_116137.jpg
