EA5IOT/Medidor-de-ruido-solar/Medidor_ruido_solar/Fotos/446304601_154019.jpg

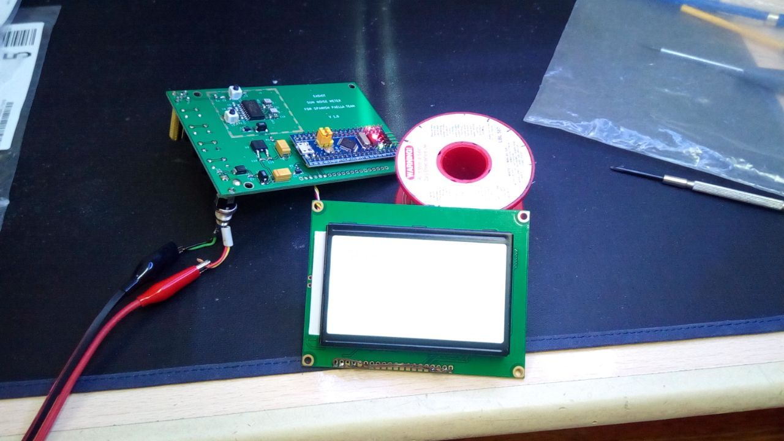
Medidor_ruido_solar/Fotos/446304601_154019.jpg
