EA5IOT/Medidor-de-ruido-solar/Medidor_ruido_solar/Fotos/446327362_158438.jpg

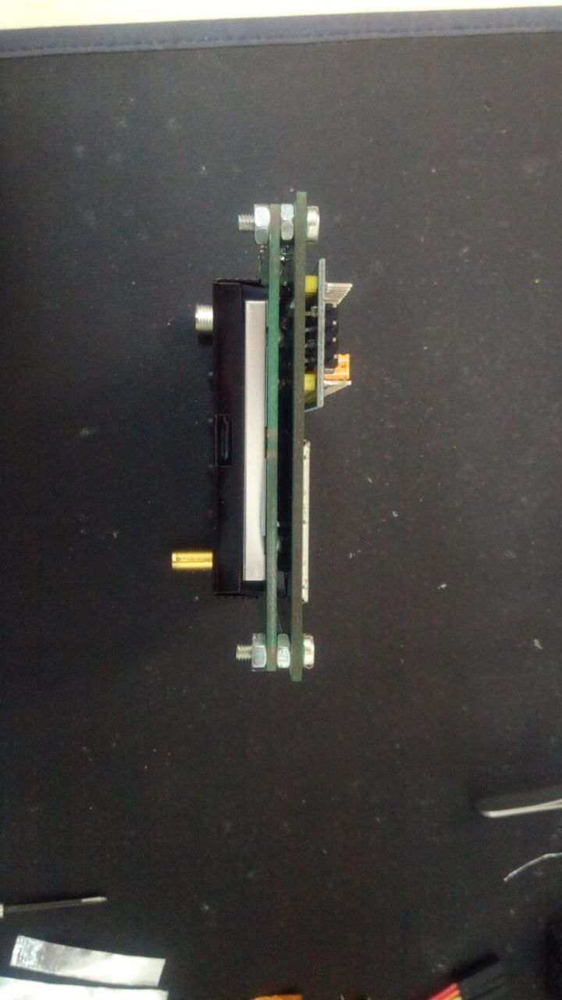
Medidor_ruido_solar/Fotos/446327362_158438.jpg
