EA5IOT/Medidor-de-ruido-solar/Medidor_ruido_solar/Fotos/446327793_214477.jpg

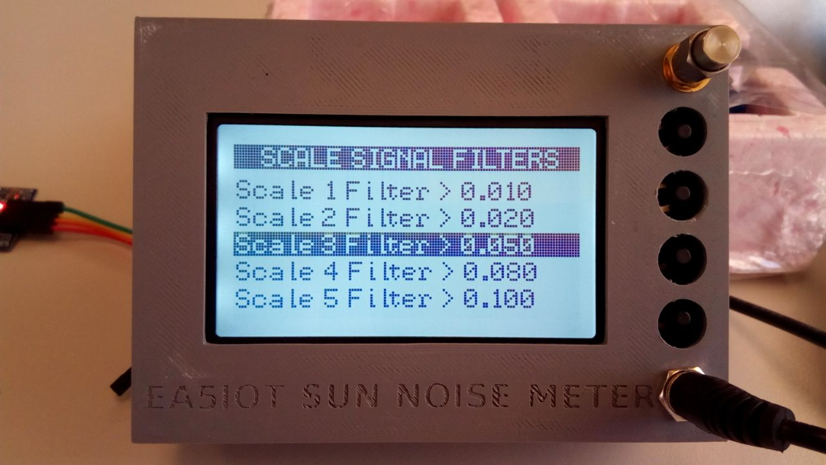
Medidor_ruido_solar/Fotos/446327793_214477.jpg
