EA5IOT/Medidor-de-ruido-solar/Medidor_ruido_solar/Fotos/446413655_126049.jpg

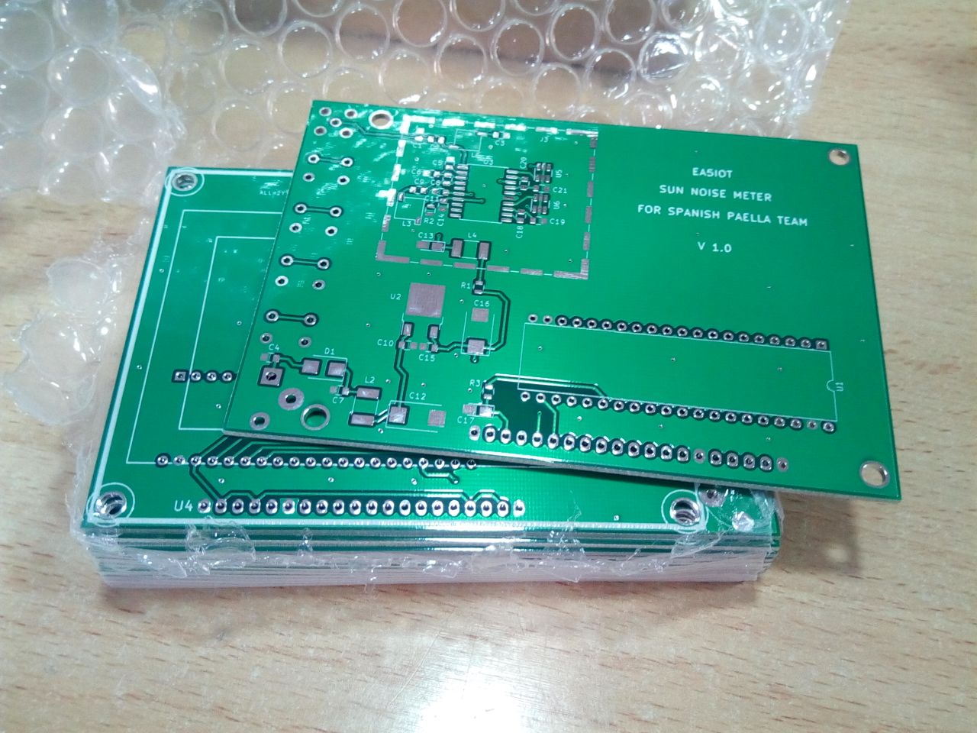
Medidor_ruido_solar/Fotos/446413655_126049.jpg
