EA5IOT/Medidor-de-ruido-solar/Medidor_ruido_solar/Fotos/446424311_152376.jpg

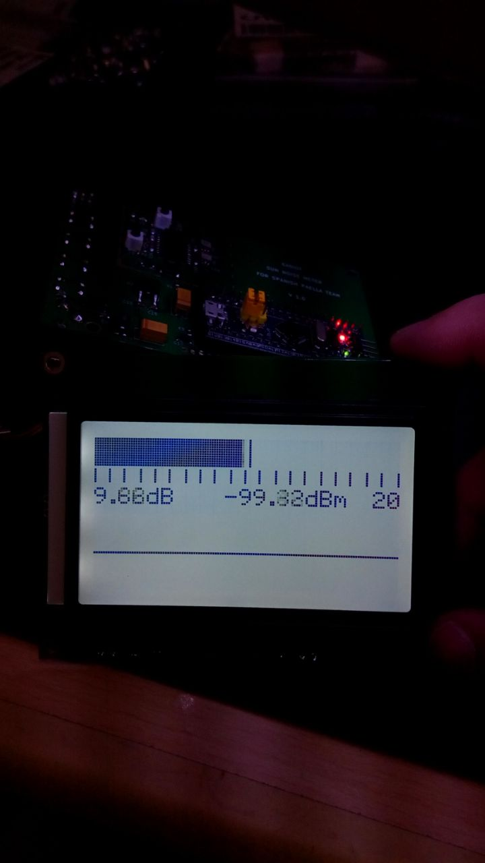
Medidor_ruido_solar/Fotos/446424311_152376.jpg
