EA5IOT/Medidor-de-ruido-solar/Medidor_ruido_solar/Fotos/446429032_239583.jpg

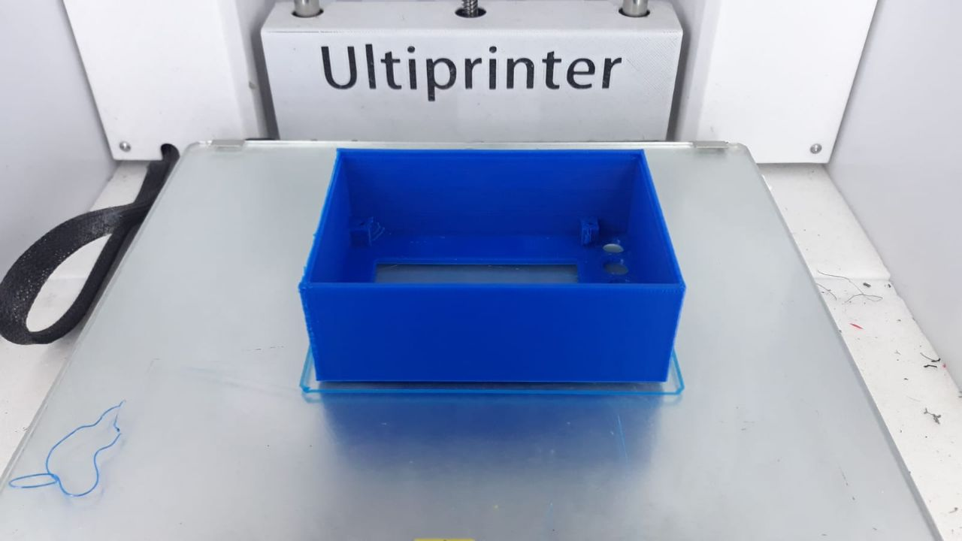
Medidor_ruido_solar/Fotos/446429032_239583.jpg
