EA5IOT/Medidor-de-ruido-solar/Medidor_ruido_solar/Fotos/446429905_247251.jpg

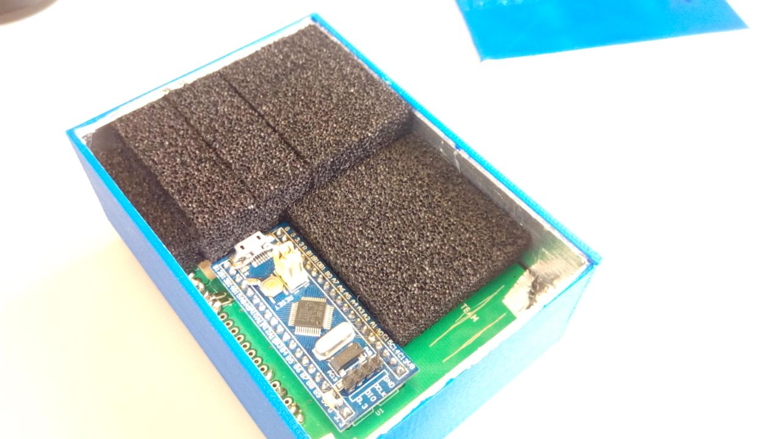
Medidor_ruido_solar/Fotos/446429905_247251.jpg
