EA5IOT/Medidor-de-ruido-solar/Medidor_ruido_solar/Fotos/446429991_158154.jpg

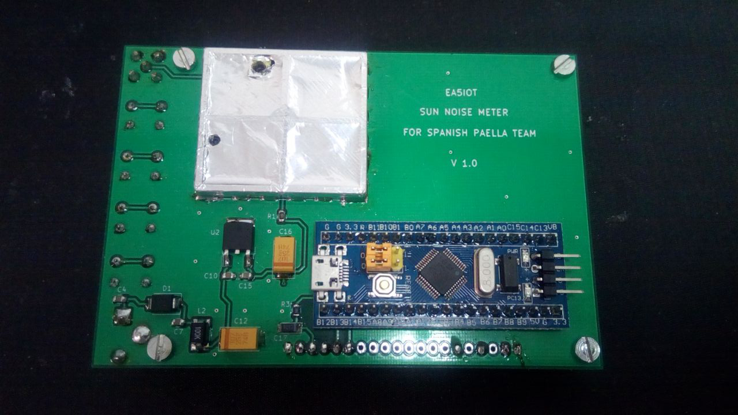
Medidor_ruido_solar/Fotos/446429991_158154.jpg
