EA5IOT/Medidor-de-ruido-solar/Medidor_ruido_solar/Fotos/446506945_209731.jpg

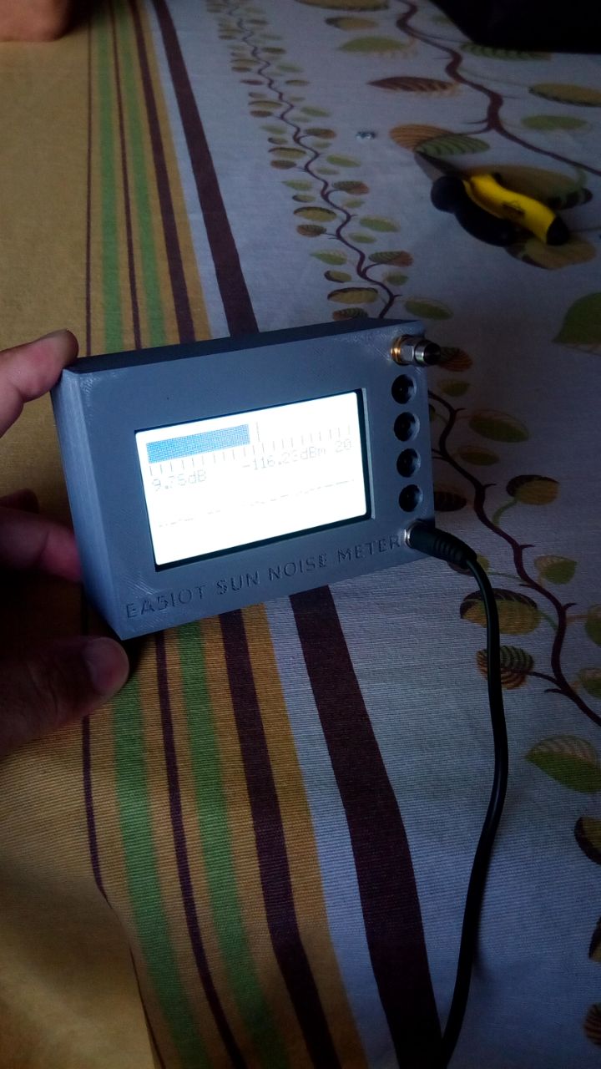
Medidor_ruido_solar/Fotos/446506945_209731.jpg
