EA5IOT/Medidor-de-ruido-solar/Medidor_ruido_solar/Fotos/446517144_118088.jpg

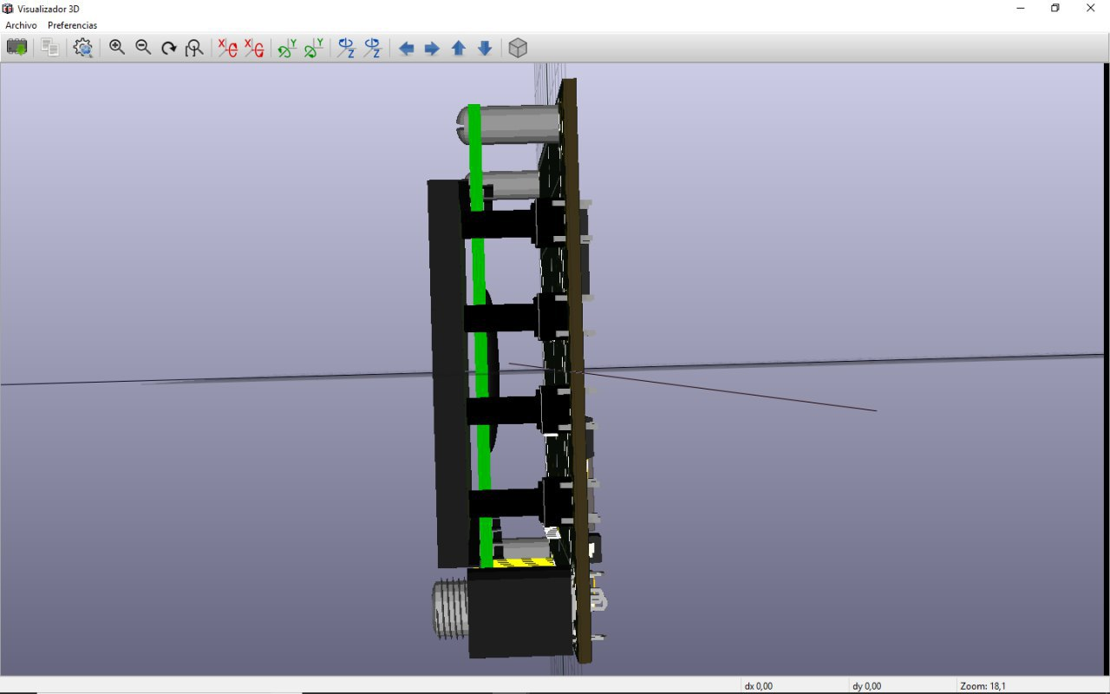
Medidor_ruido_solar/Fotos/446517144_118088.jpg
