EA5IOT/Medidor-de-ruido-solar/Medidor_ruido_solar/Fotos/446530227_118983.jpg

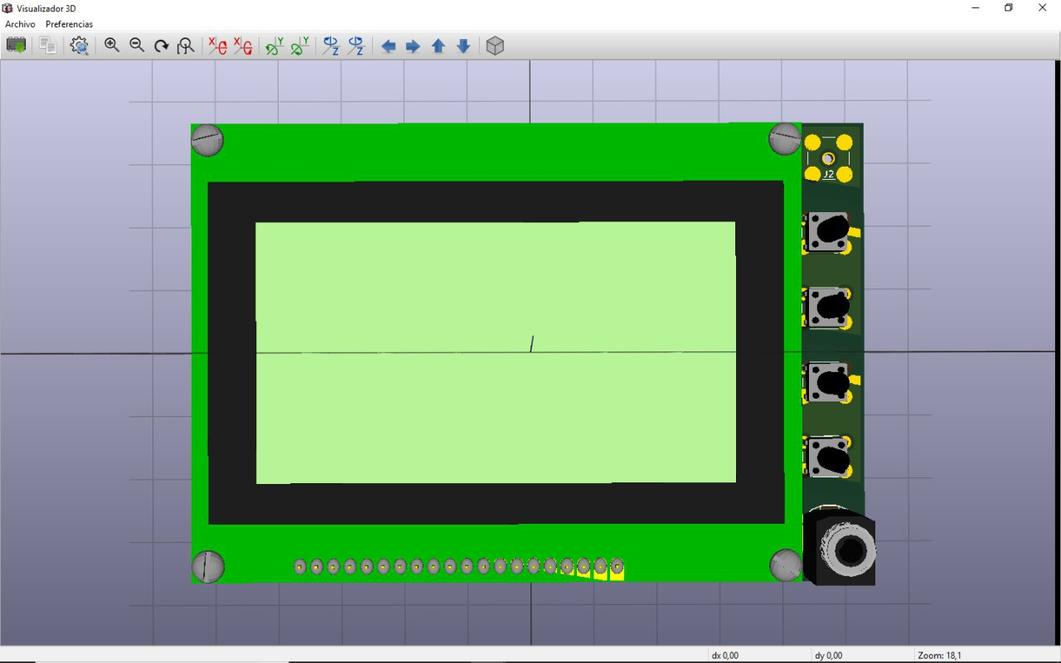
Medidor_ruido_solar/Fotos/446530227_118983.jpg
