EA5IOT/Medidor-de-ruido-solar/Medidor_ruido_solar/Fotos/446530235_113224.jpg

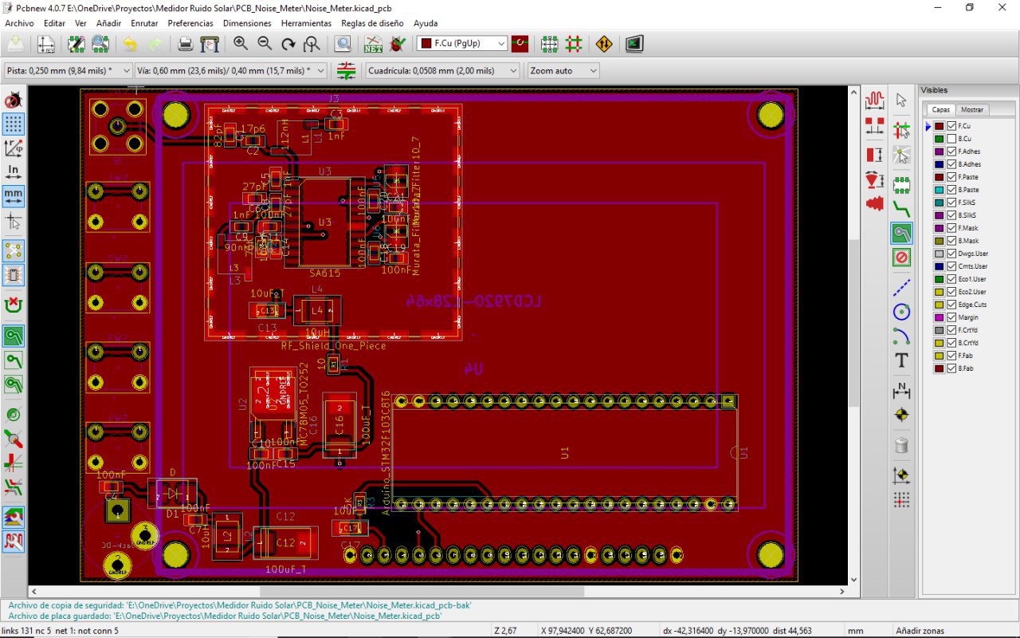
Medidor_ruido_solar/Fotos/446530235_113224.jpg
