EA5IOT/Medidor-de-ruido-solar/Medidor_ruido_solar/Fotos/446615619_114661.jpg

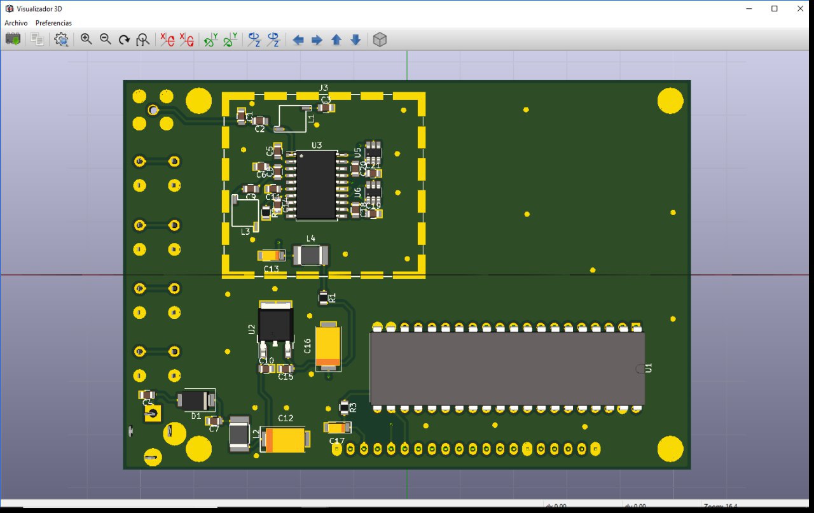
Medidor_ruido_solar/Fotos/446615619_114661.jpg
