EA5IOT/Medidor-de-ruido-solar/Medidor_ruido_solar/Fotos/446618821_153106.jpg

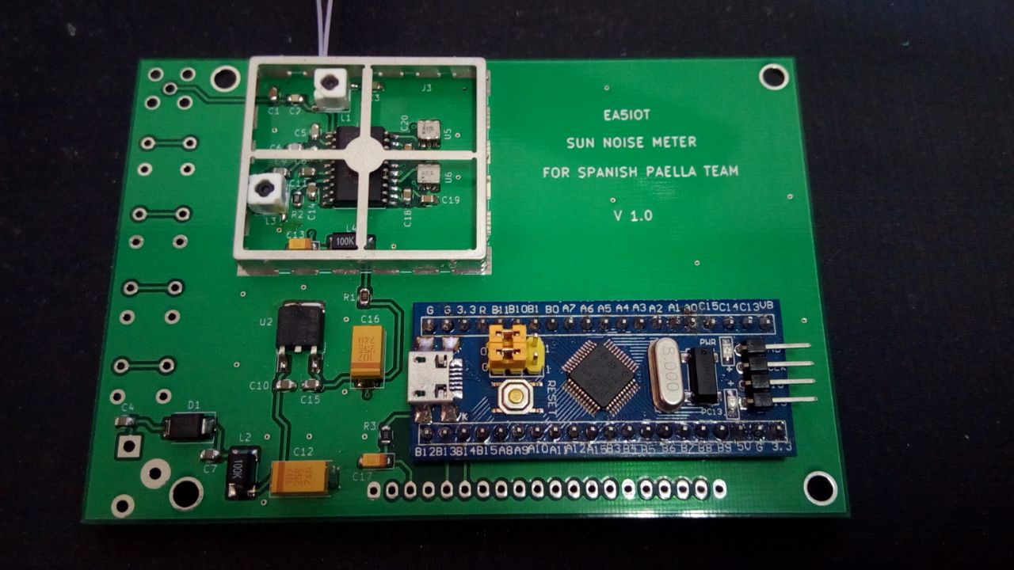
Medidor_ruido_solar/Fotos/446618821_153106.jpg
