EA5IOT/Medidor-de-ruido-solar/Medidor_ruido_solar/Fotos/446627980_236456.jpg

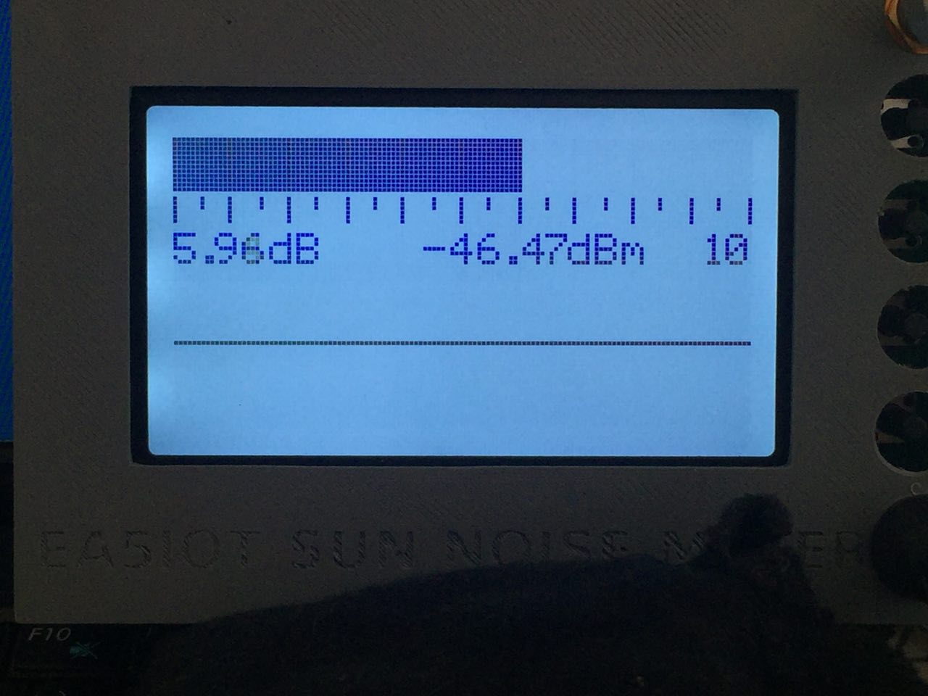
Medidor_ruido_solar/Fotos/446627980_236456.jpg
