EA5IOT/Medidor-de-ruido-solar/Medidor_ruido_solar/Fotos/446634114_114946.jpg

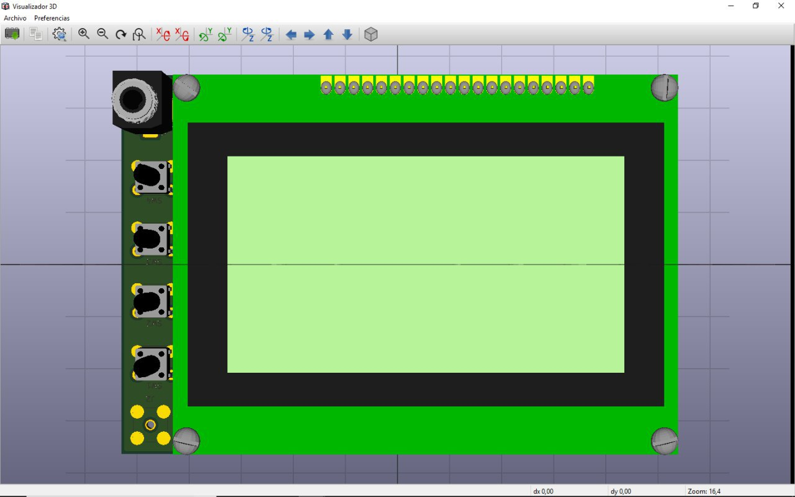
Medidor_ruido_solar/Fotos/446634114_114946.jpg
