EA5IOT/Medidor-de-ruido-solar/Medidor_ruido_solar/Fotos/446715371_216621.jpg

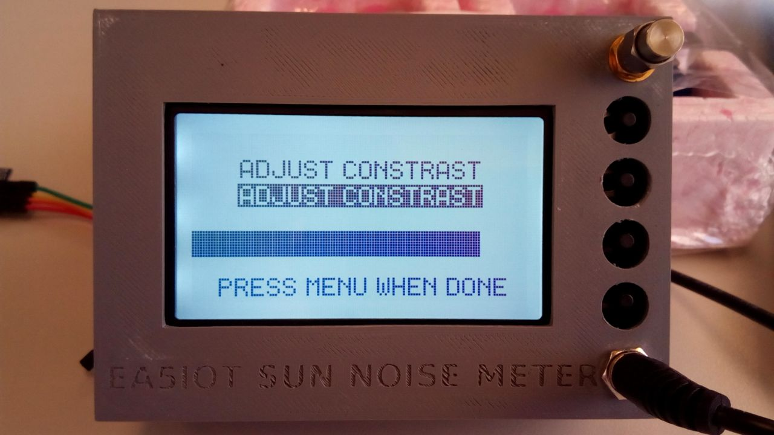
Medidor_ruido_solar/Fotos/446715371_216621.jpg
