EA5IOT/Medidor-de-ruido-solar/Medidor_ruido_solar/Fotos/446722860_109841.jpg

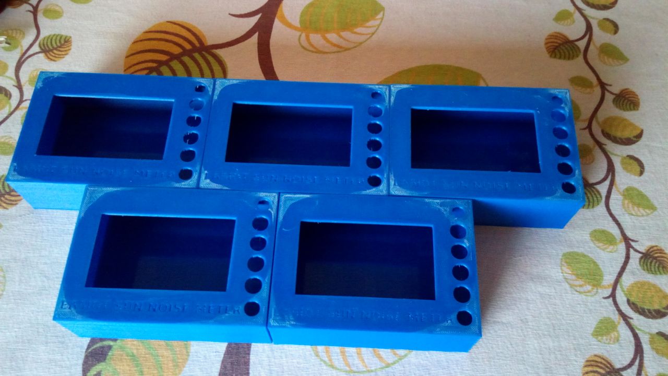
Medidor_ruido_solar/Fotos/446722860_109841.jpg
