EA5IOT/Medidor-de-ruido-solar/Medidor_ruido_solar/Fotos/446730640_111969.jpg

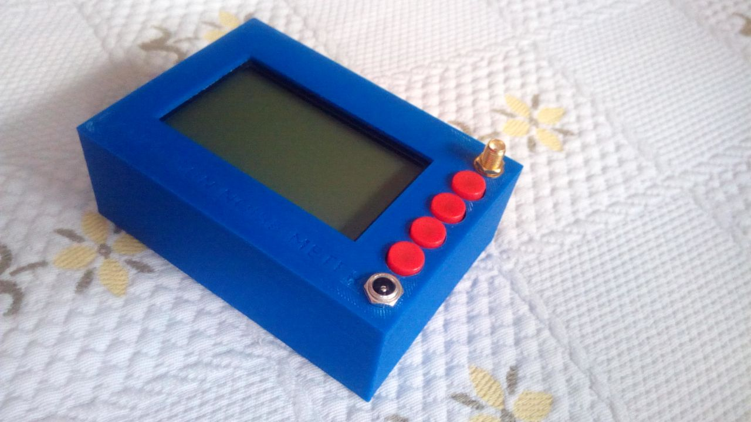
Medidor_ruido_solar/Fotos/446730640_111969.jpg
