EA5IOT/Medidor-de-ruido-solar/Medidor_ruido_solar/Fotos/446731694_36074.jpg

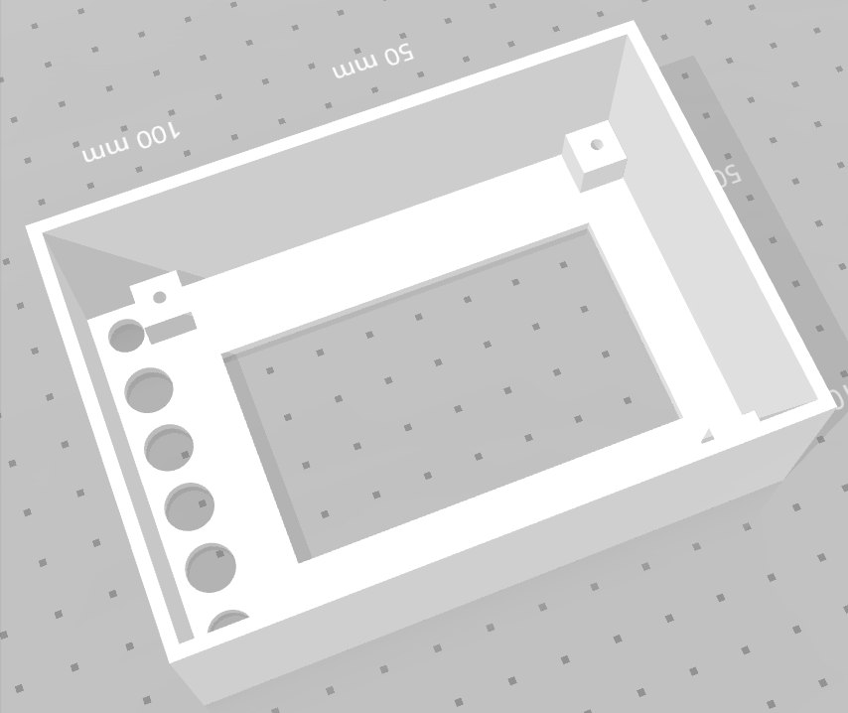
Medidor_ruido_solar/Fotos/446731694_36074.jpg
