EA5IOT/Medidor-de-ruido-solar/Medidor_ruido_solar/Fotos/446732882_117161.jpg

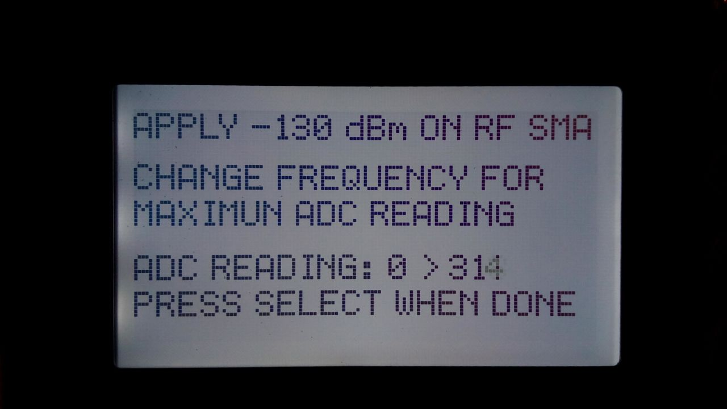
Medidor_ruido_solar/Fotos/446732882_117161.jpg
