EA5IOT/Medidor-de-ruido-solar/Medidor_ruido_solar/Fotos/446734421_25250.jpg

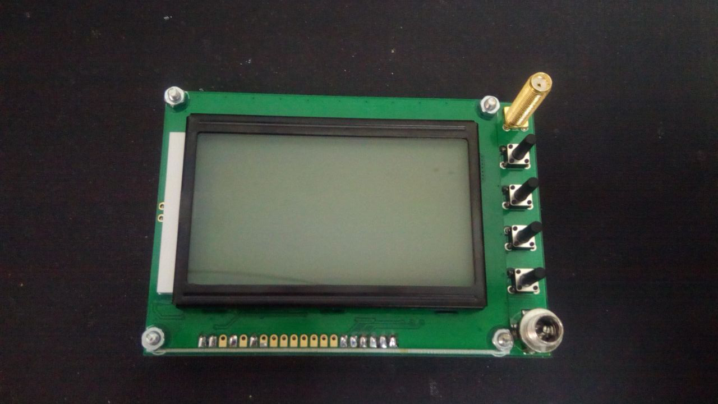
Medidor_ruido_solar/Fotos/446734421_25250.jpg
