EA5IOT/Medidor-de-ruido-solar/Medidor_ruido_solar/Fotos/446734430_55226.jpg

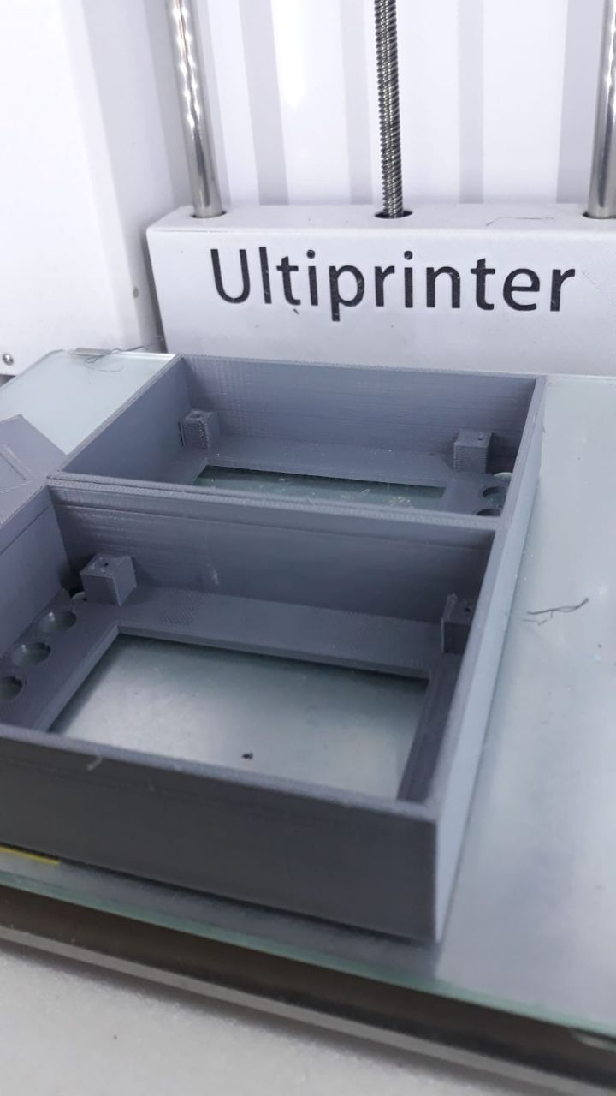
Medidor_ruido_solar/Fotos/446734430_55226.jpg
