EA5IOT/Medidor-de-ruido-solar/Medidor_ruido_solar/Fotos/448409996_82340.jpg

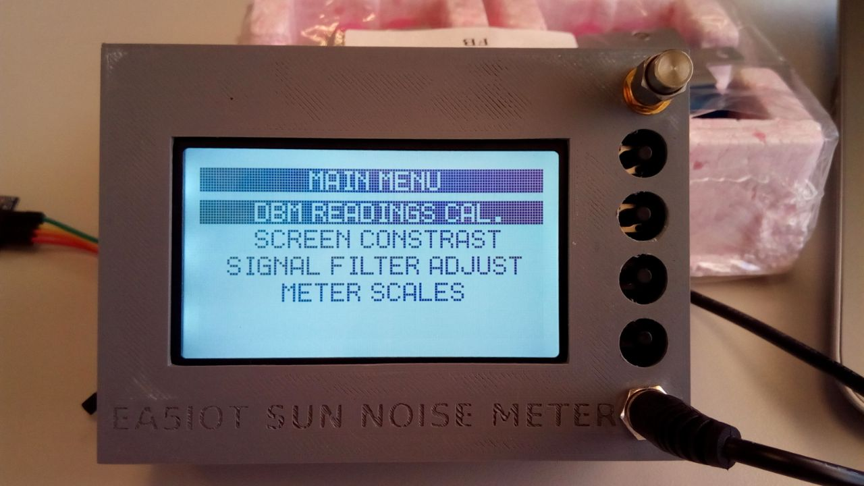
Medidor_ruido_solar/Fotos/448409996_82340.jpg
