EA5IOT/Medidor-de-ruido-solar/Medidor_ruido_solar/Fotos/448410155_112389.jpg

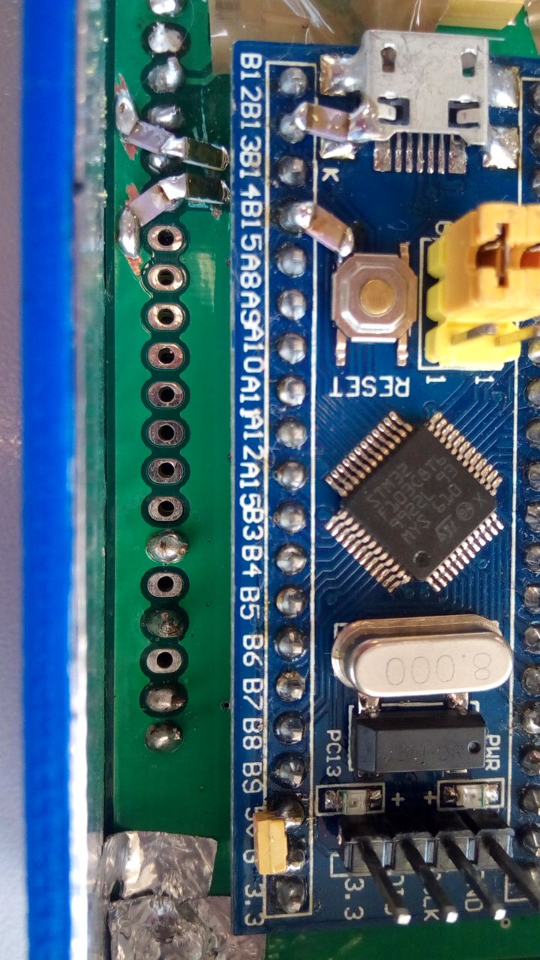
Medidor_ruido_solar/Fotos/448410155_112389.jpg
