EA5IOT/Medidor-de-ruido-solar/Medidor_ruido_solar/PCB_Noise_Meter_V1.1/BOM/Noise_Meter_BOM.ods

Id | Identificador | Empaquetado | Cantidad | Identificación | Suministrador | ref
1 | C1 | C_0805 | 1 | 82pF | Mouser | 77-VJ0805A820JXBAC
2 | C2 | C_0805 | 1 | 18pF | Mouser | 77-VJ0805A180GXACBC
3 | C3,C5,C9 | C_0805 | 3 | 1nF | Mouser | 77-VJ0805A102KXBAT
4 | C4,C7,C10,C11,C14,C15,C18,C19,C20,C21 | C_0805 | 10 | 100nF | Mouser | 77-VJ0805Y104KXAMR
5 | C6,C8 | C_0805 | 2 | 27pF | Mouser | 77-VJ0805A270GXQCBC
6 | C12,C16 | CP_Tantalum_Case-V_EIA-7343-20_Reflow | 2 | 100uF_T | Mouser | 80-T491X107M025
7 | C13,C17 | CP_Tantalum_Case-S_EIA-3216-12_Reflow | 2 | 10uF_T | Mouser | 74-TMCMA1C106MTRF
8 | D1 | D_SMB | 1 | SS26T3G | Mouser | 863-SS26T3G
9 | J1 | JACK_ALIM | 1 | Jack-DC | Ebay/Aliexpress | DC Power socket jack DC-025M
10 | J2 | SMA_THT_Jack_Straight | 1 | SMA | Ebay/Aliexpress | SMA montaje recto 29.5mm
11 | L1 | TOKO MC152 | 1 | 112nH | TOKO | E558CN-100025
12 | L2,L4 | L_1812 | 2 | 10uH | Mouser | 810-MLZ2012E100M
13 | L3 | TOKO MC152 | 1 | 90nH | TOKO | E558CN-100024
14 | R1 | R_0805 | 1 | 10 | Mouser | 755-ESR10EZPJ100
15 | R2 | R_0805 | 1 | 75K | Mouser | 603-RC0805FR-0775KL
16 | R3 | R_0805 | 1 | 1K | Mouser | 71-CRCW0805J-1K
17 | SW1,SW2,SW3,SW4 | SW_PUSH_6mm_h15mm | 4 | SW_Push | Ebay/Aliexpress | 6x6x15mm push button
18 | U1 | DIP-40_W15.24mm | 1 | Arduino_STM32F103C8T6 | Ebay/Aliexpress | STM32F103C8T6
19 | U2 | TO-252-2 | 1 | MC78M05_TO252 | Mouser | 511-L78M05CDT-TR
20 | U3 | SOIC-20W_7.5x12.8mm_Pitch1.27mm | 1 | SA615 | Mouser | 771-SA615DK/01-T
21 | U4 | AG12864E | 1 | LCD7920-128x64 | Ebay/Aliexpress | St7920 128x64
23 | Y2 | Resonator_SMD_muRata_SFECV-3pin_6.9x2.9mm | 2 | 10,7Mhz | Mouser | 81-SFECF10M7FA00-R0
24 | J3 | Laird_Technologies_BMI-S-206-F_36.83x33.68mm | 1 | RF_Shield_One_Piece | Mouser | 739-BMIS-206-F
