EA5IOT/Medidor-de-ruido-solar/Medidor_ruido_solar/Caja_3D/Tapa_Caja_Medidor_Ruido_Solar.stl

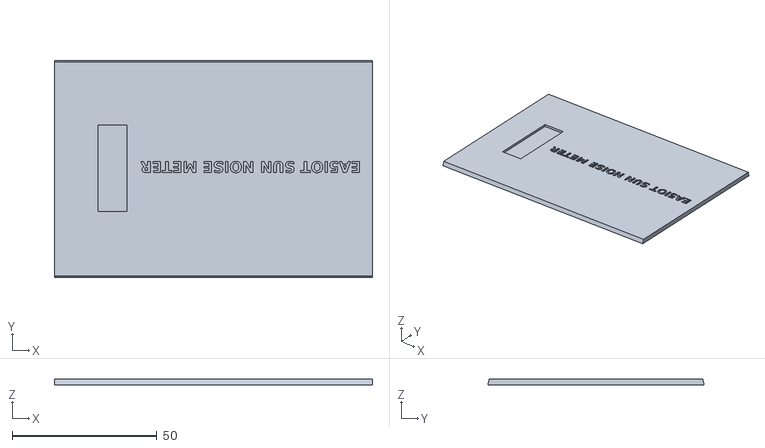
[picture p68: CAD file, 2018-09-10]
Medidor_ruido_solar/Caja_3D/Tapa_Caja_Medidor_Ruido_Solar.stl
110.0 x 74.9 x 2.00
