EA5IOT/Medidor-de-ruido-solar/Medidor_ruido_solar/Caja_3D/Caja_Medidor_Ruido_Solar.stl

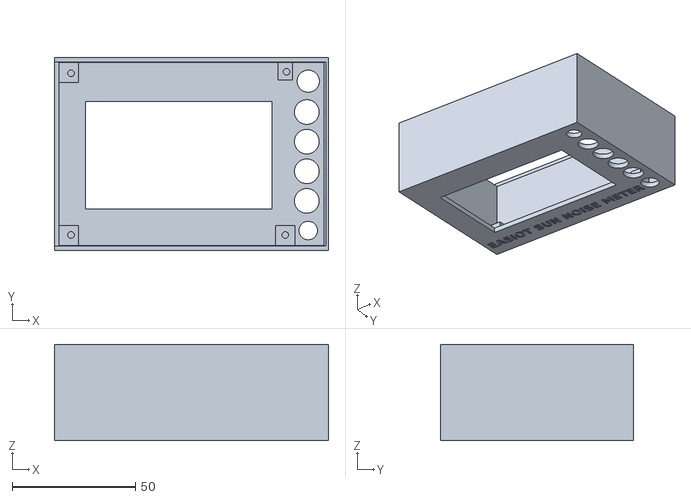
[picture p69: CAD file, 2018-09-10]
Medidor_ruido_solar/Caja_3D/Caja_Medidor_Ruido_Solar.stl
111.0 x 78.0 x 39.0
