EA5IOT/Medidor-de-ruido-solar/Medidor_ruido_solar/Cargador_Balanceador/Cargador_Balanceador.pdf

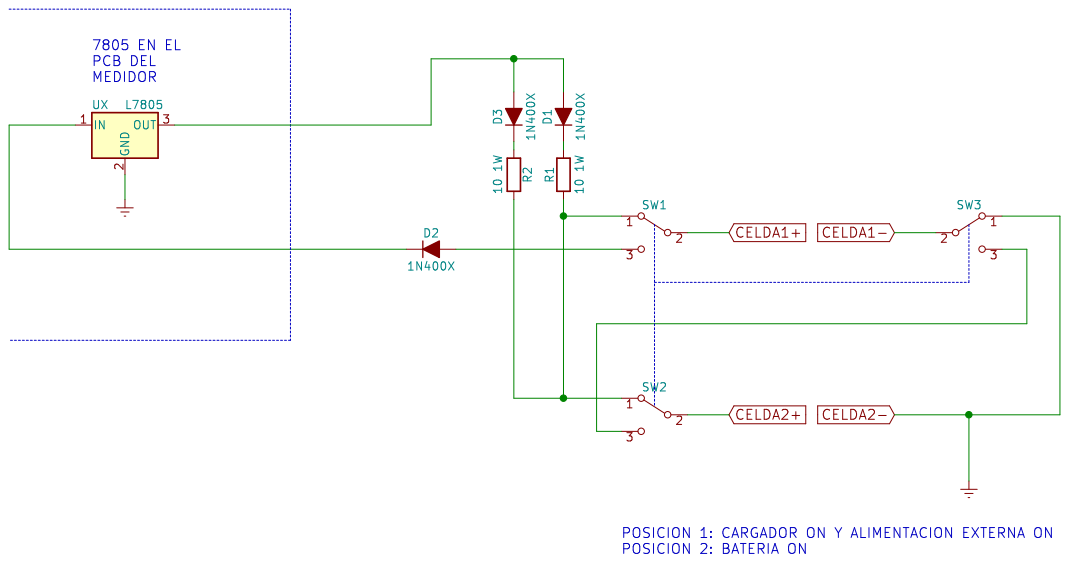
[picture p71: page 1]
