EA5IOT/Medidor-de-ruido-solar/Medidor_ruido_solar/Cargador_Baterias_Litio/Cargador_Baterias_Litio.pdf

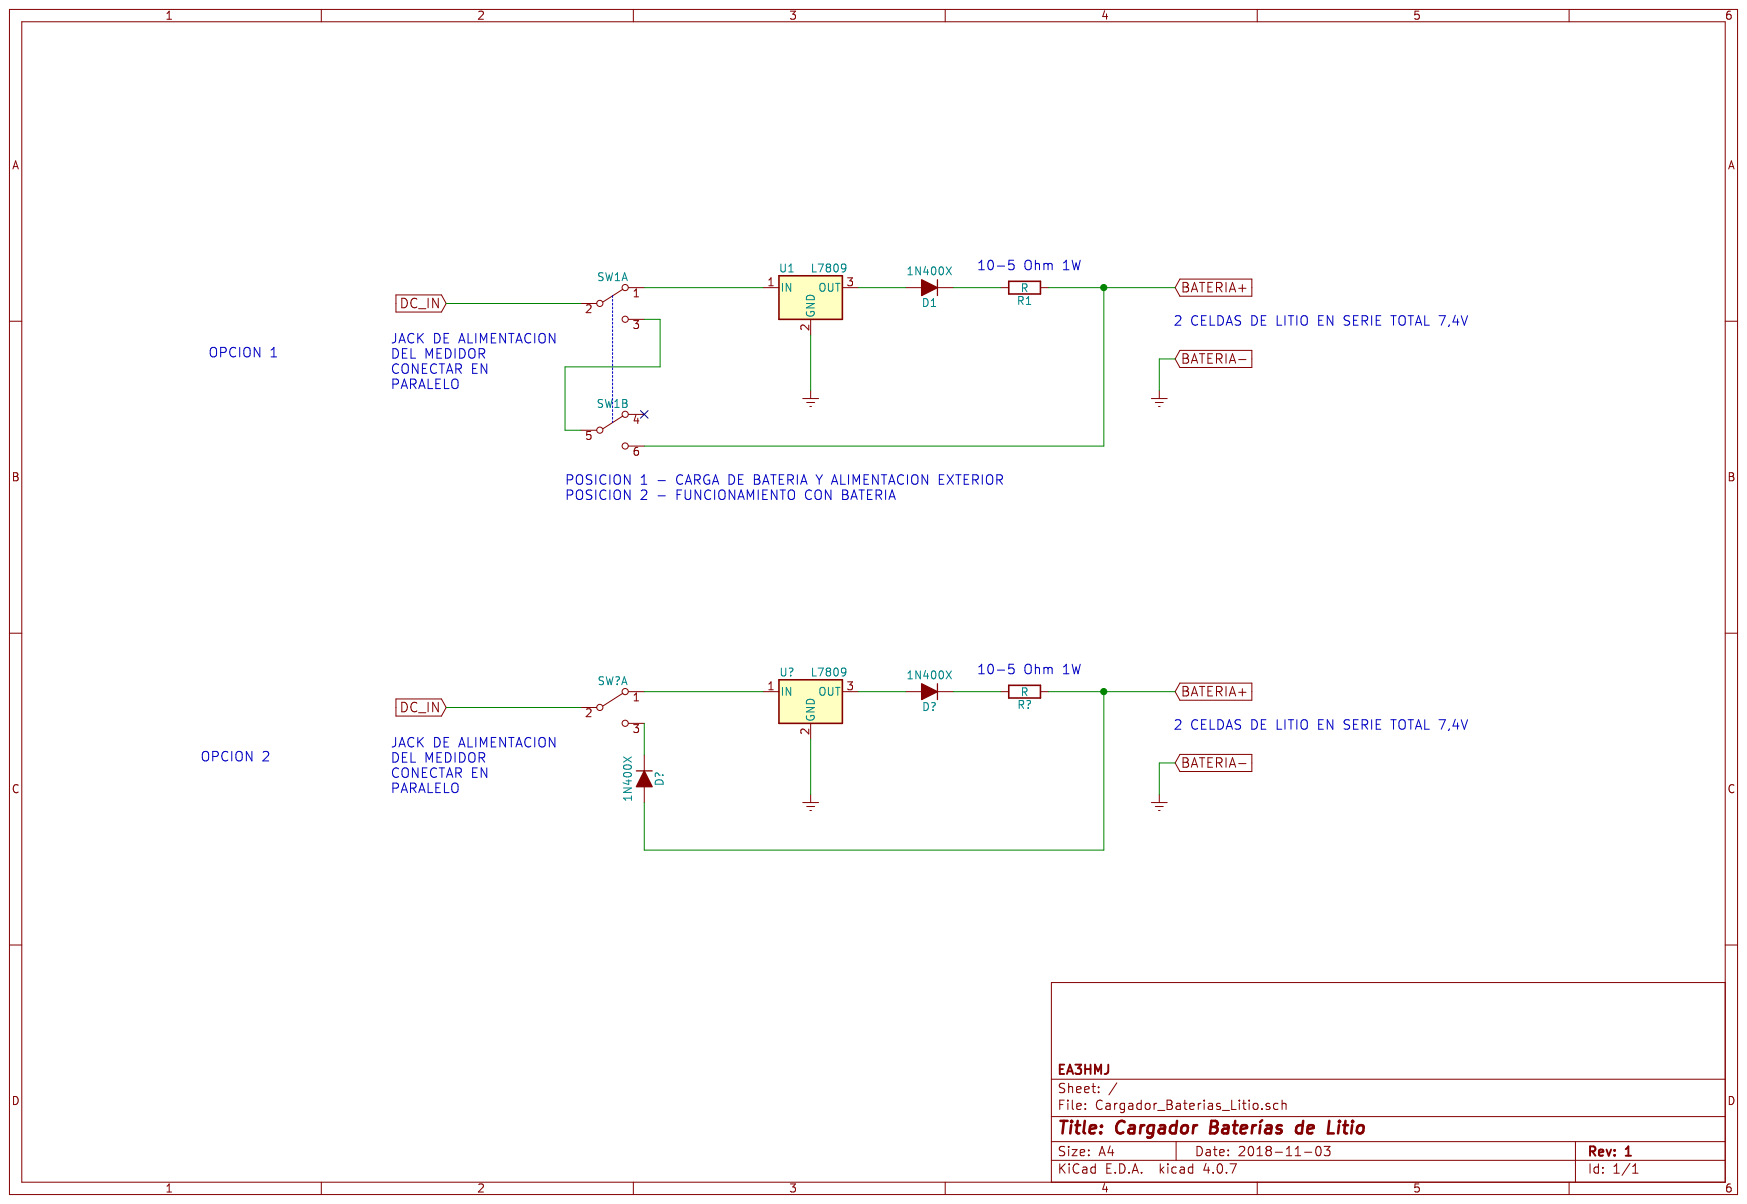
[picture p72: page 1]
