EA5IOT/Medidor-de-ruido-solar/Medidor_ruido_solar/PCB_Noise_Meter_V1.1/Noise_Meter_V1.1.pdf

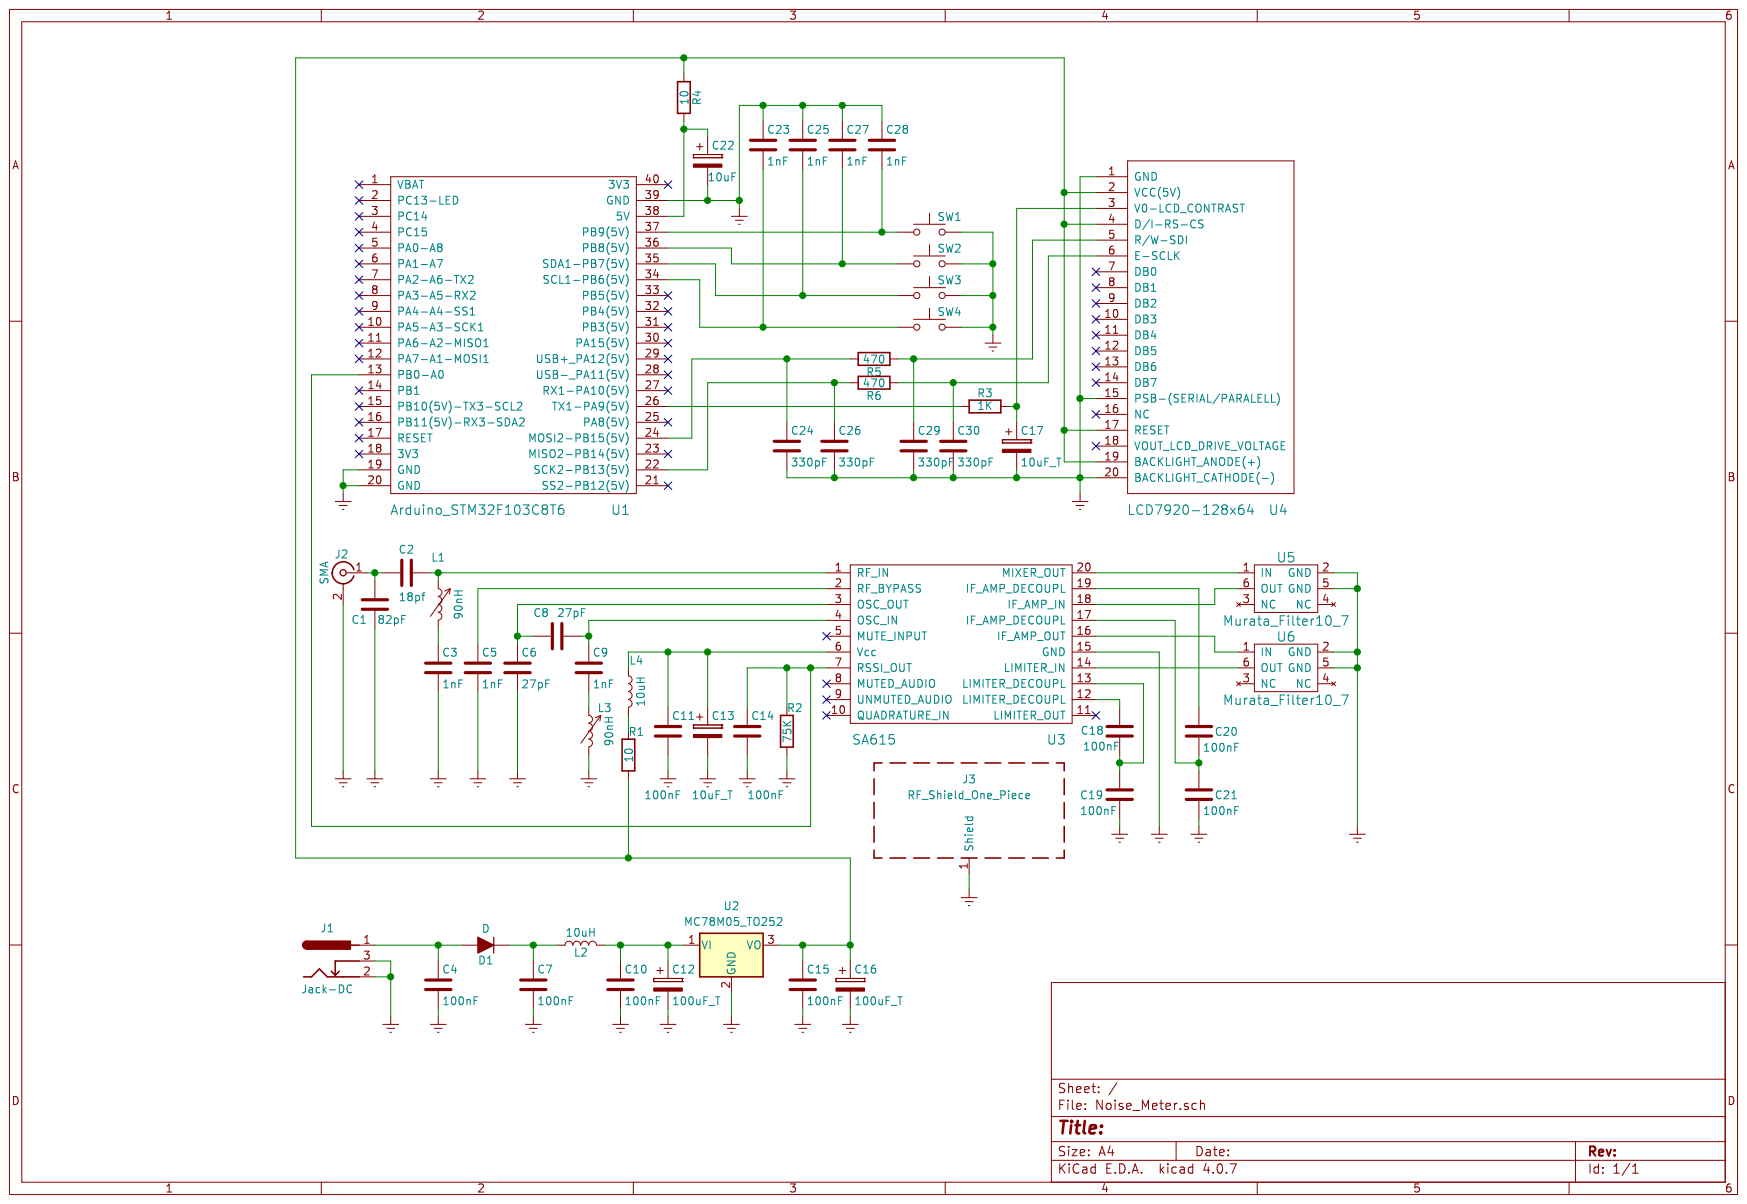
[picture p73: page 1]
