EA5IOT/Medidor-de-ruido-solar/Medidor_ruido_solar/PCB_Noise_Meter_V1.1/Noise_Meter.kicad_pcb

## KiCad design Medidor_ruido_solar/PCB_Noise_Meter_V1.1/Noise_Meter.kicad_pcb (2019-02-19)

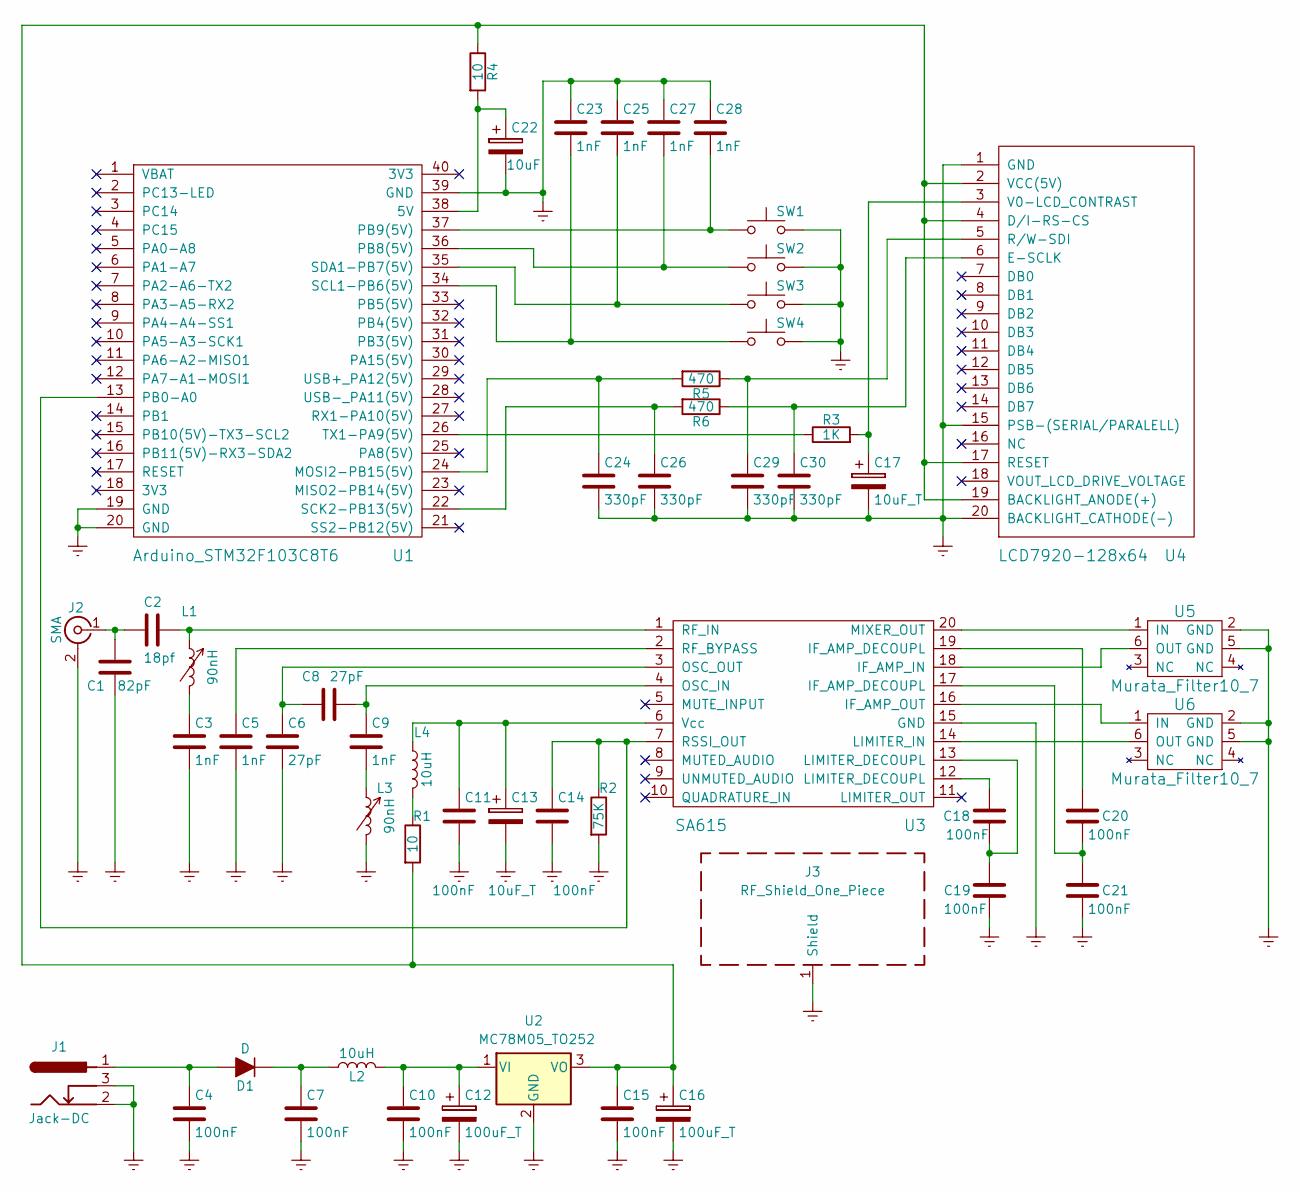
[picture p74: schematic Noise_Meter.sch]

Parts:
C1: 82pF; C_0805
C2: 18pf; C_0805
C3, C5, C9, C23, C25, C27, C28: 1nF; C_0805
C4, C7, C10, C11, C14, C15, C18, C19, C20, C21: 100nF; C_0805
C6, C8: 27pF; C_0805
C12, C16: 100uF_T; CP_Tantalum_Case-V_EIA-7343-20_Reflow
C13, C17: 10uF_T; CP_Tantalum_Case-S_EIA-3216-12_Reflow
C22: 10uF; CP_Tantalum_Case-S_EIA-3216-12_Reflow
C24, C26, C29, C30: 330pF; C_0805
D1: D; D_SMB
J1: Jack-DC; JACK_ALIM
J2: SMA; SMA_THT_Jack_Straight
J3: RF_Shield_One_Piece; Laird_Technologies_BMI-S-206-F_36.83x33.68mm
L1, L3: 90nH; L_Neosid_Air-Coil_SML_3turn_HAM0331A
L2, L4: 10uH; L_1812
R1, R4: 10; R_0805
R2: 75K; R_0805
R3: 1K; R_0805
R5, R6: 470; R_0805
SW1, SW2, SW3, SW4: SW_Push; SW_PUSH_6mm_h13mm
U1: Arduino_STM32F103C8T6; DIP-40_W15.24mm
U2: MC78M05_TO252; TO-252-2
U3: SA615; SOIC-20W_7.5x12.8mm_Pitch1.27mm
U4: LCD7920-128x64; AG12864E
U5, U6: Murata_Filter10_7; SOT-23-6_Handsoldering

Connections:
GNDREF: C1.1, C3.2, C4.2, C5.2, C6.2, C7.2, C10.2, C11.2, C12.2, C13.2, C14.2, C15.2, C16.2, C17.2, C19.2, C21.2, C22.2, C23.1, C24.2, C25.1, C26.2, C27.1, C28.1, C29.2, C30.2, J1.2, J1.3, J2.2 (Ext), J3.1, L3.2, R2.2, SW1.2, SW2.2, SW3.2, SW4.2, U1.19 (GND), U1.20 (GND), U1.39 (GND), U2.2 (GND), U3.15 (GND), U4.1 (GND), U4.15 (PSB-(SERIAL/PARALELL)), U4.20 (BACKLIGHT_CATHODE(-)), U5.2 (GND), U5.5 (GND), U6.2 (GND), U6.5 (GND)
unnamed: C1.2, C2.2, J2.1 (In)
unnamed: C2.1, L1.1, U3.1 (RF_IN)
unnamed: C3.1, L1.2
unnamed: C4.1, D1.2 (A), J1.1
unnamed: C5.1, U3.2 (RF_BYPASS)
unnamed: C6.1, C8.2, U3.3 (OSC_OUT)
unnamed: C7.1, D1.1 (K), L2.1
unnamed: C8.1, C9.1, U3.4 (OSC_IN)
unnamed: C9.2, L3.1
unnamed: C10.1, C12.1, L2.2, U2.1 (VI)
unnamed: C11.1, C13.1, L4.1, U3.6 (Vcc)
unnamed: C14.1, R2.1, U1.13 (PB0-A0), U3.7 (RSSI_OUT)
unnamed: C15.1, C16.1, R1.2, R4.1, U2.3 (VO), U4.2 (VCC(5V)), U4.4 (D/I-RS-CS), U4.17 (RESET), U4.19 (BACKLIGHT_ANODE(+))
unnamed: C17.1, R3.2, U4.3 (V0-LCD_CONTRAST)
unnamed: C18.1, C19.1, U3.13 (LIMITER_DECOUPL)
unnamed: C18.2, U3.12 (LIMITER_DECOUPL)
unnamed: C20.1, U3.19 (IF_AMP_DECOUPL)
unnamed: C20.2, C21.1, U3.17 (IF_AMP_DECOUPL)
unnamed: C22.1, R4.2, U1.38 (5V)
unnamed: C23.2, SW4.1, U1.34 (SCL1-PB6(5V))
unnamed: C24.1, R5.2, U1.24 (MOSI2-PB15(5V))
unnamed: C25.2, SW3.1, U1.35 (SDA1-PB7(5V))
unnamed: C26.1, R6.2, U1.22 (SCK2-PB13(5V))
unnamed: C27.2, SW2.1, U1.36 (PB8(5V))
unnamed: C28.2, SW1.1, U1.37 (PB9(5V))
unnamed: C29.1, R5.1, U4.5 (R/W-SDI)
unnamed: C30.1, R6.1, U4.6 (E-SCLK)
unnamed: L4.2, R1.1
unnamed: R3.1, U1.26 (TX1-PA9(5V))
unnamed: U3.14 (LIMITER_IN), U6.6 (OUT)
unnamed: U3.16 (IF_AMP_OUT), U6.1 (IN)
unnamed: U3.18 (IF_AMP_IN), U5.6 (OUT)
unnamed: U3.20 (MIXER_OUT), U5.1 (IN)

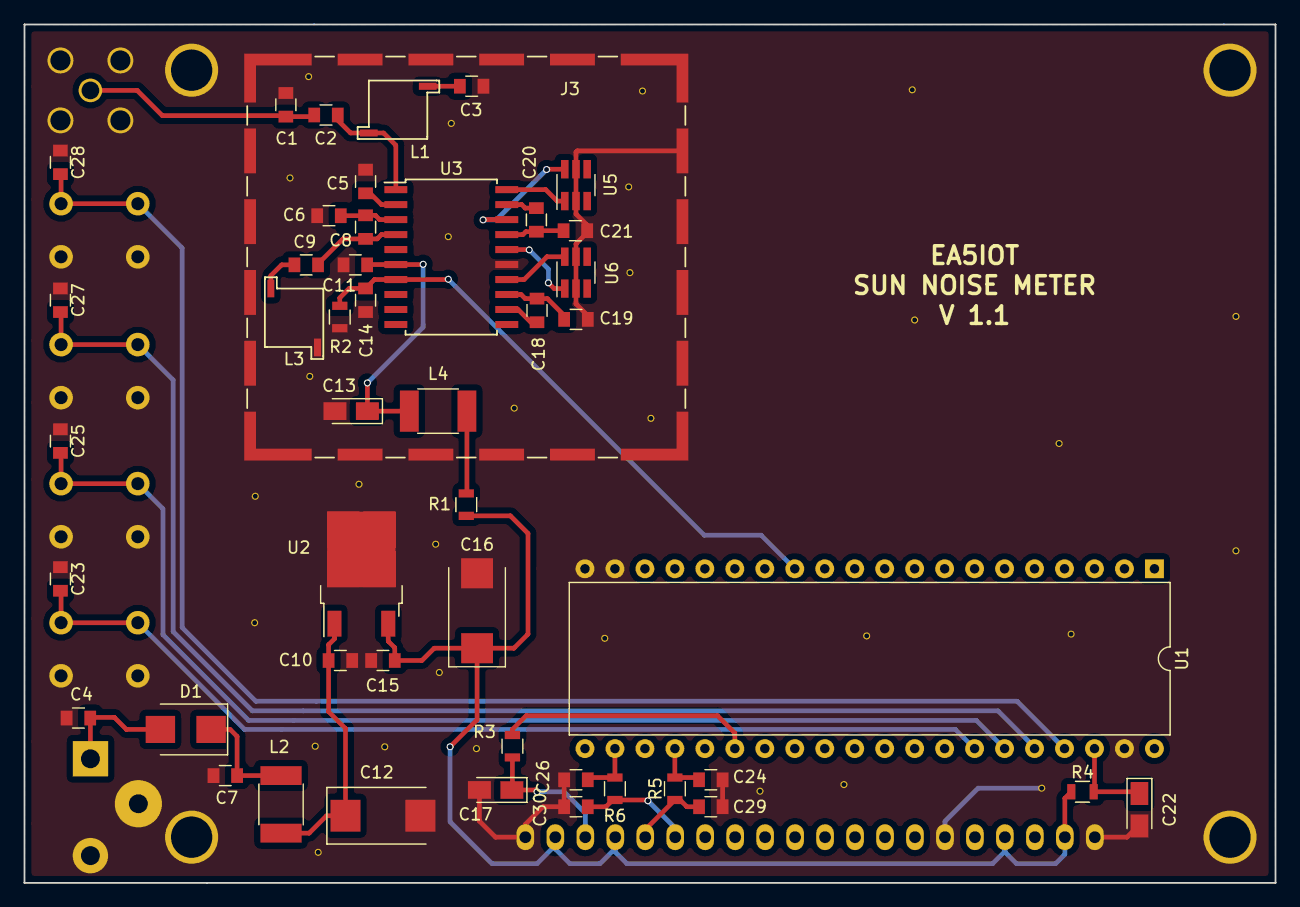
[picture p75: board Noise_Meter.kicad_pcb from above]

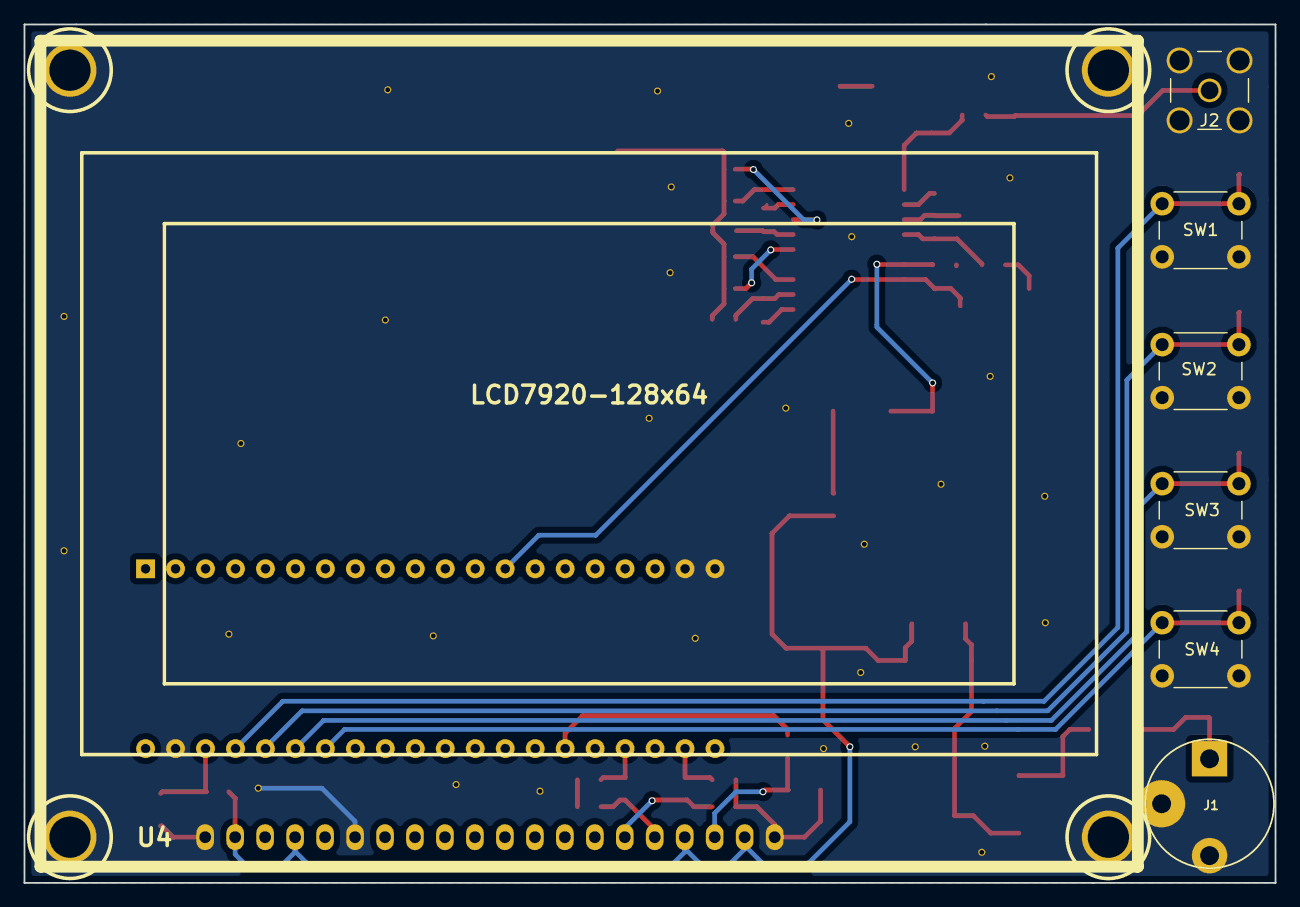
[picture p76: board Noise_Meter.kicad_pcb from below]

Board: 2 copper layers, 106.0 x 72.7 mm, 54 parts (7 on the bottom side), 34 nets.
