EA5IOT/Medidor-de-ruido-solar/(commit log)

2018-11-03 Cargador_Bateria_Litio
    Cargador_Bateria_litio
    [Cargador_Baterias_Litio.kicad_pcb, Cargador_Baterias_Litio.sch]
2018-11-03 Medidor_Ruido_Solar
    Cargador Balanceador
    [Cargador_Balanceador.kicad_pcb, Cargador_Balanceador.sch, Cargador_Baterias_Litio.sch]
2018-11-03 Medidor_Ruido_Solar
    Medidor_Ruido_Solar
    [Cargador_Balanceador.sch]
2018-11-18 Cargador Balanceador
    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
    [Cargador_Balanceador-2018-11-18-12-13-31.sch]
2019-01-26 BOM updated
    [Noise_Meter_BOM.ods]
2019-01-30 Update Medidor_ruido_solar/Firmware/Medidor_de_ruido_solar_V1.6/Medidor_de_ruido_solar_V1.6.ino
    Medidor de ruido solar
2019-02-19 Medidor Ruido Solar
    Presentacion
    [Noise_Meter-B.Cu.gbr, Noise_Meter-B.Mask.gbr, Noise_Meter-B.SilkS.gbr, Noise_Meter-Edge.Cuts.gbr, Noise_Meter-F.Cu.gbr, Noise_Meter-F.Mask.gbr, Noise_Meter-F.SilkS.gbr, Noise_Meter-NPTH.drl]
2019-04-04 Create Medidor_de_ruido_solar_V1.7.ino
    2db calibration points
2019-04-29 Track 17 files into repository.
    - modified LICENSE
    - modified Medidor_ruido_solar/Cargador_Balanceador/Cargador_Balanceador-cache.lib
    - modified Medidor_ruido_solar/Cargador_Balanceador/Cargador_Balanceador-rescue.lib
    - modified Medidor_ruido_solar/Cargador_Balanceador/Cargador_Balanceador.bak
    - modified Medidor_ruido_solar/Cargador_Balanceador/Cargador_Balanceador.pro
    - modified Medidor_ruido_solar/Cargador_Balanceador/Cargador_Balanceador.sch
    - modified Medidor_ruido_solar/Cargador_Balanceador/rescue-backup/Cargador_Balanceador-2018-11-18-12-13-31.pro
    - modified Medidor_ruido_solar/Cargador_Balanceador/rescue-backup/Cargador_Balanceador-2018-11-18-12-13-31.sch
    - modified Medidor_ruido_sola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
    [Cargador_Balanceador-2018-11-18-12-13-31.sch, Cargador_Balanceador.sch, Cargador_Baterias_Litio.sch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]
2019-04-29 Track 3 files into repository.
    - removed assets/import.png
    - removed assets/Presentacion2.jpg
    - modified README.md
    Auto commit by GitBook Editor
