EA5IOT/Medidor-de-ruido-solar/(notices)

Notices in the files:
Medidor_ruido_solar/Firmware/Medidor_de_ruido_solar_V2.1/Medidor_de_ruido_solar_V2.1.ino:
This program is free software: you can redistribute it and/or modify
it under the terms of the GNU General Public License as published by
the Free Software Foundation, either version 3 of the License, or
(at your option) any later version.
